dxoverdy/Gliderol2MQTT/README.md

# Gliderol2MQTT
## A smart home interface for Gliderol Electric Garage Doors driven by Glidermatic controllers.
Gliderol2MQTT (or G2M for short) is a smart home remote control and monitoring interface for Gliderol Electric Garage Doors which are driven by Glidermatic controllers.

Let's be honest.  Gliderol garage doors are pretty awesome out of the box, but what if we could make them a bit smarter?  Say, hook them into your Apple Home, Google Assistant, Amazon Alexa or Home Assistant?  Well, now you can.  And you can do it without a soldering iron.  Communication with Gliderol2MQTT is via MQTT and can be driven by home integration solutions such as [Home Assistant](https://www.home-assistant.io/), [Node-Red](https://nodered.org/) and anything else which is MQTT compatible.  It has in-built compatibility with [Homebridge](https://homebridge.io/) and the [Homebridge MQTT-Thing](https://github.com/arachnetech/homebridge-mqttthing) plugin so you can control and monitor your garage door natively from your iPhone/Apple Watch/HomePod with your voice or via the app.  It's as simple as saying "Hey Siri, close the garage door."

Further, as the project is low power and makes use of the 12V/GND/UP/DOWN/STOP screw terminals on the PCB of the Glidermatic controller, it can be powered by the Glidermatic controller itself and so it doesn't need its own power supply.  It supports an optional OLED display for your project box and an optional Micro-SD card reader for changing settings without needing to re-flash the ESP32 each time.  The slightly simpler implementation only requires a roller shutter door sensor on the floor to work, reporting Open / Closed / Opening (Fob/Button/MQTT) / Closing (MQTT).  For best results however, an optional spring actuator limit switch at the top is supported to report the full Open / Stopped / Closed / Opening (Fob/Button/MQTT) / Closing (Fob/Button/MQTT) range of states.

It's designed to run on an ESP32 microcontroller with a small amount of supporting components.  Estimated cost to build is around £40 for the simpler implementation and £65 for the full on implementation... But the kudos is priceless :D.

### Supported devices are:
```
GLIDERMATIC GRD,
GLIDERMATIC GTS / GTS+,
*Others models which expose 12V, GND, UP, STOP and DOWN terminals on the PCB will work too.  Be sure to let me know if yours needs adding!
**There are models which just have a 12V, GND, ST (Start).  Whilst I don't have this model, in theory, Gliderol2MQTT will work just fine, leveraging just one relay for START.  I would love to hear from and work with you if you have a model like this so that the project can be refined for you and all.
```

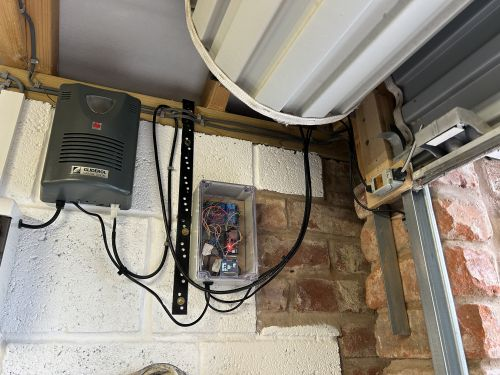
[picture p1: Pics/Assembly/Small/Finished2.JPG]
Gliderol2MQTT


*Watch the video of my implementation here:*

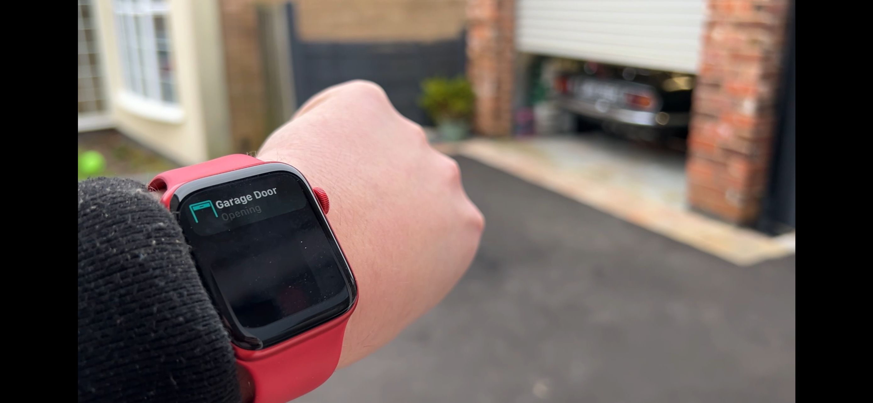
[picture p2: Pics/VidImage.jpg]
Watch the video of my implementation here


We will run through the communications first, we will then look at building and implementation before finally plumbing it into Homebridge or Home Assistant and demonstrate how it all comes together.  I have been running my Gliderol2MQTT for over a year.  I debated whether to release it to the public because it is such a great device it could have been a small side income stream, however, I ultimately decided to release the design and code to the public.  This is not a two minute project.  It is a weekend fun project which involves everything from a bit of DIY, some easy electronics and a teeny bit of ESP32 flashing with PlatformIO in Visual Studio Code.  Have a marathon approach to this project in your head, a sprint will only frustrate you.  I will endeavour to help if you get stuck.  Try email or [Facebook](https://www.facebook.com/mydan100/).

Enjoy.

(c) Daniel Young 2022/23/24 [daniel@mydan.com](daniel@mydan.com)

# MQTT Communication
## Connection Established / Dropped
Gliderol2MQTT needs WiFi access and a connection to an MQTT broker to work.  If MQTT communication is lost for around 20 seconds (1.5 x the 15 second keep-alive) due to patchy WiFi or network outage, Gliderol2MQTT will show as offline.  But rest assured, Gliderol2MQTT will always endeavour to reconnect to both WiFi and MQTT as soon as possible.  Use the following MQTT topic for Birth and Last Will and Testament, which you can use to indicate to HomeKit and Home Assistant that the device is online or offline:
```
Gliderol2MQTT/connection_status
```

### Birth
When connection to the MQTT broker is established, it will post a retained MQTT message to Gliderol2MQTT/connection_status with the following payload:
```
true
```
Where true means Gliderol2MQTT is online.  Gliderol2MQTT is assumed as online from then on - until communication is lost.

### Last Will and Testament
As stated, when MQTT communication is lost for around 20 seconds, your MQTT broker will send out the Last Will and Testament for Gliderol2MQTT.  It is a retained MQTT message to Gliderol2MQTT/connection_status with the following payload:
```
false
```
Where false means Gliderol2MQTT is offline.

### Boot Report
Once per boot, after first connecting to the broker, Gliderol2MQTT publishes a retained JSON message to:
```
Gliderol2MQTT/device/boot
```
For example:
```
{"time": "2026-11-07T08:15:02Z", "reset_reason": "software", "boot_count": 42, "online_after_ms": 12873,
 "version": "v2.0", "firmware_md5": "3f2a...", "ip": "192.168.1.50", "mac": "0x..."}
```
- **time** - UTC, from NTP.  `null` if the time couldn't be fetched.
- **reset_reason** - `power_on`, `external` (reset button), `software` (includes the reboot after an OTA update), `crash`, `watchdog`, `brownout` (supply voltage dipped) or `unknown`.
- **boot_count** - boots since first flashed; survives reboots and reflashing.
- **online_after_ms** - time from power-on to this message.  It includes the "Determine status" wait, so expect a little over your longest door time.
- **firmware_md5** - fingerprint of the running firmware; it changes with every build, which confirms an OTA update really landed.
- **rssi** - WiFi signal strength in dBm at boot.  Roughly: above -60 excellent, -60 to -70 good, -70 to -80 weak, below -80 unreliable.

### Device Status
Every minute (and on connecting), Gliderol2MQTT publishes a retained health report to:
```
Gliderol2MQTT/device/status
```
For example:
```
{"uptime_s":86400,"rssi":-63,"free_heap":201468,"min_free_heap":187952}
```
- **uptime_s** - seconds since boot.
- **rssi** - current WiFi signal strength in dBm (see above).
- **free_heap** / **min_free_heap** - free memory now, and the lowest it has been since boot.  A steady downward trend over days would point to a memory leak.

If the firmware ever hangs, a watchdog reboots it after 30 seconds, and the boot report then shows `"reset_reason": "watchdog"`.

## Current State
The MQTT topic to subscribe to is:
```
Gliderol2MQTT/get/current/door/state
```
### get/current/door/state
To keep your home automation tools informed as to your garage door's current state, Gliderol2MQTT publishes this topic every minute and whenever it (re)connects to the broker.  This topic is also published on demand when there is either a change of floor sensor or top sensor state, or when you tell Gliderol2MQTT to do something.  For example, if you instruct Gliderol2MQTT to open the door via an MQTT message, the topic will be published immediately.  If there is a change in door state by way of using the keyfob or push button on the Glidermatic, it will likewise publish the topic immediately.   To take two real life examples a bit further, if you send Gliderol2MQTT a message to shut the door, this will return 'c' (Closing) for a time period* and then, if the door has fully shut, return 'C' (Closed) from then on.  Similarly, if you use the fob to open the door from a fully closed position, this will return 'o' (Opening) for a time period* and then, if the door has fully opened, return 'O' (Open) from then on.  With the top sensor fitted, it reports the final state the moment the sensor at the destination confirms the door has arrived, without waiting out the time period.  If the time period* passes with the door still part-way, it allows a further five seconds' grace (`MOVEMENT_GRACE_MS`) in case the door is just running slow, and only then reports 'S' (Stopped).

```
o - The door is currently Opening.
O - The door is currently Open.
c - The door is currently Closing.
C - The door is currently Closed.
S - The door is currently Stopped.
```

*Time Periods are customisable numbers of seconds it takes for your garage door to both open from a fully closed position or close from a fully open position - as these are all dependent on the model and the height of the door.*

*Without the top sensor as part of your implementation, only 'o' and 'O' can be reported on change of floor sensor state or if you instruct Gliderol2MQTT to open the door by way of an MQTT message.  Further, 'c' and 'C' can only be reported when the door is fully shut or if you instruct Gliderol2MQTT to close the door by way of an MQTT message.  This is because a change in top sensor state is required to determine if you close the door with the keyfob or push button on the Glidermatic.  'S' cannot be reported without the top sensor as both sensor states need to be known to determine if the door is stopped somewhere between.*

## Target State
The MQTT topic to subscribe to is:
```
Gliderol2MQTT/get/target/door/state
```
### get/target/door/state
This informs your home automation tool as to what the target door state is and is only sent out on demand.  Take two examples, if you send Gliderol2MQTT a message to shut the door, this will return 'C' (Closed) - Our target is an eventual closed position.  And if you press the keyfob to open the door from a fully closed position, this will return 'O' (Open) - Our target is an eventual open position.  

*Without the top sensor as part of your implementation, only 'O' can be reported on change of floor sensor state or if you instruct Gliderol2MQTT to open the door by way of an MQTT message.  Further, 'C' can only be reported when the door is fully shut or if you instruct Gliderol2MQTT to close the door by way of an MQTT message.  This is because a change in top sensor state is required to determine if you close the door with the keyfob or push button on the Glidermatic.*
```
O - The door is working towards its Open position.
C - The door is working towards its Closed position.
```

## Requesting States
You can ask Gliderol2MQTT about the state of the door as it is right now.  The MQTT topics to publish empty payloads to are:
```
Gliderol2MQTT/request/is/open
Gliderol2MQTT/request/is/closed
Gliderol2MQTT/request/is/stopped
```

### request/is/open
Following an empty payload published to the topic 'Gliderol2MQTT/request/is/open', you will receive a response on Gliderol2MQTT/response/is/open.  The response payload is JSON akin to the following:
```
{"open":true}
```
The value is true (Door open) or false (Door not open.)

### request/is/closed
Following an empty payload published to the topic 'Gliderol2MQTT/request/is/closed', you will receive a response on Gliderol2MQTT/response/is/closed.  The response payload is JSON akin to the following:
```
{"closed":true}
```
The value is true (Door closed) or false (Door not closed.)

### request/is/stopped
Following an empty payload published to the topic 'Gliderol2MQTT/request/is/stopped', you will receive a response on Gliderol2MQTT/response/is/stopped.  The response payload is JSON akin to the following:
```
{"partiallyopen":true}
```
The value is true (Door partially open) or false (Door fully closed or open.)

*When you leverage a top sensor as part of your implementation.*

## Requesting Actions
You can ask Gliderol2MQTT to open, close or stop the door from home automation tools such as Home Assistant or Node Red.  The MQTT topics to publish empty payloads to are:
```
Gliderol2MQTT/request/perform/close
Gliderol2MQTT/request/perform/open
Gliderol2MQTT/request/perform/stop
```

You can also ask Gliderol2MQTT to reboot itself:
```
Gliderol2MQTT/request/perform/reboot
```

If you are integrating with HomeKit using Homebridge and MQTT-Thing, Gliderol2MQTT has you covered.  You use this topic instead:
```
Gliderol2MQTT/set/target/door/state
```

### set/target/door/state
This topic instructs Gliderol2MQTT to open (O) or close (C) the door.  Simply publish a message to this topic with a single character payload, the letter C or letter O.  This works out of the box with MQTT-Thing but can also be used in any other home automation tools too.
```
O - The door is working towards its Open position.
C - The door is working towards its Closed position.
```
Once you have published to this topic, you will receive the same payload back to 'Gliderol2MQTT/get/target/door/state' as confirmation that the target was set.

*This indicates the action was triggered, but does not guarantee anything.  Your home automation will use the current state to report the outcome over time.*

### request/perform/close
Following an empty payload published to the topic 'Gliderol2MQTT/request/perform/close', you will receive a response on Gliderol2MQTT/response/perform/close.  The response payload is JSON akin to the following:
```
{"statusValue":"setCloseSuccess","done":true}
```
*This indicates the action was triggered, but does not guarantee anything.  Your home automation will use the current state to report the outcome over time.*

### request/perform/open
Following an empty payload published to the topic 'Gliderol2MQTT/request/perform/open', you will receive a response on Gliderol2MQTT/response/perform/open.  The response payload is JSON akin to the following:
```
{"statusValue":"setOpenSuccess","done":true}
```
*This indicates the action was triggered, but does not guarantee anything.  Your home automation will use the current state to report the outcome over time.*

### request/perform/stop
Following an empty payload published to the topic 'Gliderol2MQTT/request/perform/stop', you will receive a response on Gliderol2MQTT/response/perform/stop.  The response payload is JSON akin to the following:
```
{"statusValue":"setStopSuccess","done":true}
```
*This indicates the action was triggered, but does not guarantee anything.  Your home automation will use the target and current states to report the outcome.*

### request/perform/reboot
Following an empty payload published to the topic 'Gliderol2MQTT/request/perform/reboot', you will receive a response on Gliderol2MQTT/response/perform/reboot, after which the device releases all relays, publishes `false` to connection_status and restarts.  The response payload is JSON akin to the following:
```
{"statusValue":"setRebootSuccess","done":true}
```
Once back online, Gliderol2MQTT/device/boot will show `"reset_reason": "software"`.

### Retained command messages
Command topics (perform open/close/stop/reboot and set/target/door/state) must not be published with the retain flag.  As a safeguard, Gliderol2MQTT deletes any retained message on its command topics each time it connects, and ignores commands arriving in the first 1.5 seconds after subscribing - otherwise a stray retained "open" would open the door, or a retained "reboot" would cause a reboot loop, every time the device reconnected.

## Other MQTT Topics
There are other topics which were implemented to assist in development.  They are listed below but without too much by way of detail.  They set, clear and return the individual ESP32 pin values for the relays driving the garage door and the sensor values.  The value topics reply with `{"value":"high"}` or `{"value":"low"}`, and set/clear reply with `{"done":true}`.  You shouldn't need them, but it gives those of you who investigate the source code in depth some context.
```
Gliderol2MQTT/request/value/pin/close, Response via Gliderol2MQTT/response/value/pin/close
Gliderol2MQTT/request/value/pin/stop, Response via Gliderol2MQTT/response/value/pin/stop
Gliderol2MQTT/request/value/pin/open, Response via Gliderol2MQTT/response/value/pin/open
Gliderol2MQTT/request/value/pin/top_sensor, Response via Gliderol2MQTT/response/value/pin/top_sensor
Gliderol2MQTT/request/value/pin/bottom_sensor, Response via Gliderol2MQTT/response/value/pin/bottom_sensor
Gliderol2MQTT/request/value/pin/wake_button, Response via Gliderol2MQTT/response/value/pin/wake_button
```

*The set and clear topics below directly energise/release the relays, so they are compiled out by default.  Uncomment `#define ENABLE_DEV_TOPICS` in Definitions.h to enable them.*
```
Gliderol2MQTT/request/set/value/pin/close, Response via Gliderol2MQTT/response/set/value/pin/close
Gliderol2MQTT/request/set/value/pin/stop, Response via Gliderol2MQTT/response/set/value/pin/stop
Gliderol2MQTT/request/set/value/pin/open, Response via Gliderol2MQTT/response/set/value/pin/open

Gliderol2MQTT/request/clear/value/pin/close, Response via Gliderol2MQTT/response/clear/value/pin/close
Gliderol2MQTT/request/clear/value/pin/stop, Response via Gliderol2MQTT/response/clear/value/pin/stop
Gliderol2MQTT/request/clear/value/pin/open, Response via Gliderol2MQTT/response/clear/value/pin/open
```

# How To Build
## Parts List
1. An ESP32 microcontroller

2. A 3-channel 3.3V DC relay board

3. A prototyping board - 120mm x 80mm

4. A 12V to 5V step down buck converter*

5. A 4-pin IIC 128x64 OLED Screen (optional)

6. A Micro-SD Card Reader (optional)

7. A roller shutter door sensor

8. A spring actuator limit switch (optional)

9. Some 5 Core 30 AWG Cable**

10. Some 2 Core 30 AWG Cable***

11. A project box to put it all in

12. Miscellaneous 2.54mm pitch male and female headers, and mix of varying length Female-Female (F-F) jumper wires

*I have designed this project with zero soldering in mind, but ultimately my personal implementation does use soldering as I have a small soldering kit and I'm pretty competent at it and it made for a slightly tidier job.  You will be able to implement this entirely solderless using breadboards.  The only component where I couldn't find a pre-soldered equivalent was the 12V to 5V converter.  I suspect they will be available if you search a little harder than I did.  I like the 12V to 5V converter as it means the whole thing can be powered from the Glidermatic itself but it isn't essential as you could use your own Micro-USB power supply for the ESP32.

** You will need enough 5 core cable to reach from your Glidermatic to wherever you fix your Gliderol2MQTT.  I listed the item below but you can do as I did, position it near the glidermatic and use any spare 1m network cable you have lying around if you want to save yourself a bit of money.  Black is likely to be a better colour for the project.

*** You will need enough 2 core cable to reach from your Gliderol2MQTT to the bottom sensor, and optionally, a second length from your Gliderol2MQTT to the top sensor, if you choose to implement the top sensor.  Black is likely to be a better colour for the project.

### ESP32 + optional case : ESP32-WROOM-32E : Development Board Dual Core : LATEST!
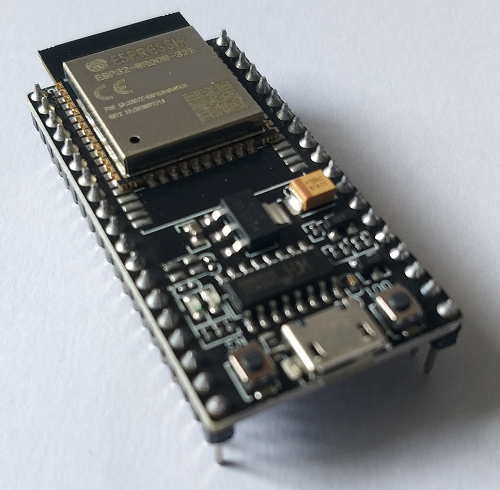
[picture p3: Pics/ESP32.png]
ESP32-WROOM-32E


Forgoe the box.  I guess any ESP32 variant will do, but I use the 38 pin version with 3V3 and GND at the top left and right respectively.  I bought [for £6.95 including P&P](https://www.ebay.co.uk/itm/195866751998)

### DC 3.3V 5V 3-Channel Relay Module With Optocoupler Isolation Compatible Signal
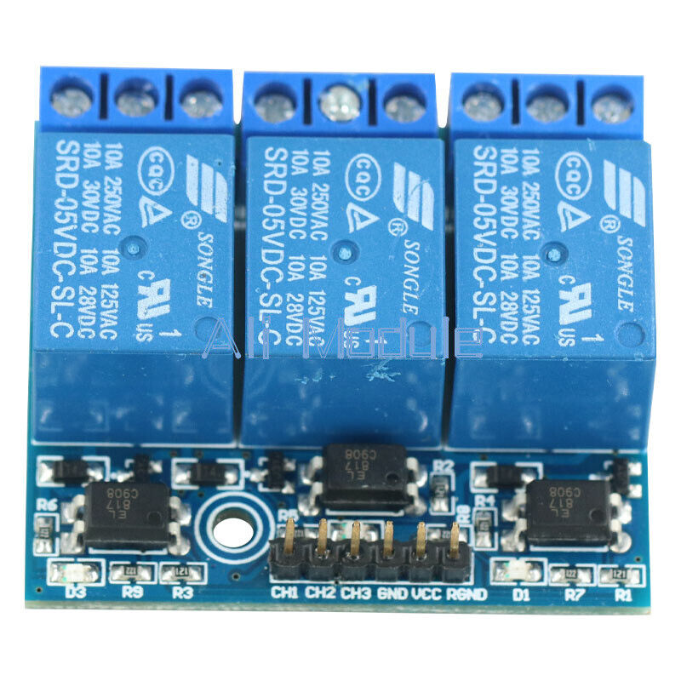
[picture p4: Pics/RelayBoard.JPG]
3 Channel Relay Board


I bought [for £4.69 including P&P](https://www.ebay.co.uk/itm/254991837221)

*Note that this relay board is powered by 5V to activate the relays, however is driven by 3.3V signals.  You may find a relay board which can be powered by 3.3V too and you will need to adjust your build below such that you have a 3.3V rail to share with any other 3.3V devices, such as the display.*

### Prototype Board - Double Sided - 80x120mm - 8x12cm Green / Silver - UK Free P&P
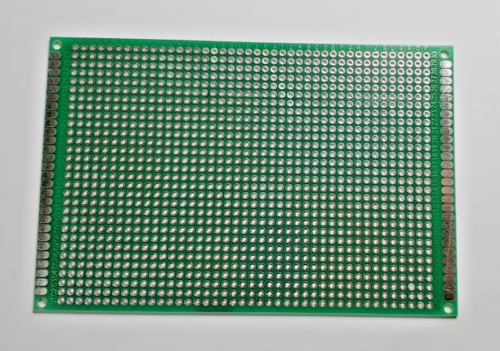
[picture p5: Pics/PrototypingBoard.PNG]
Prototyping Board


I bought [this for £2.99 including P&P](https://www.ebay.co.uk/itm/266162433248)

### Mini560 5V-20V To 3.3V/5V/9V/12V 5A Step Down Buck Converter Power Supply -UK
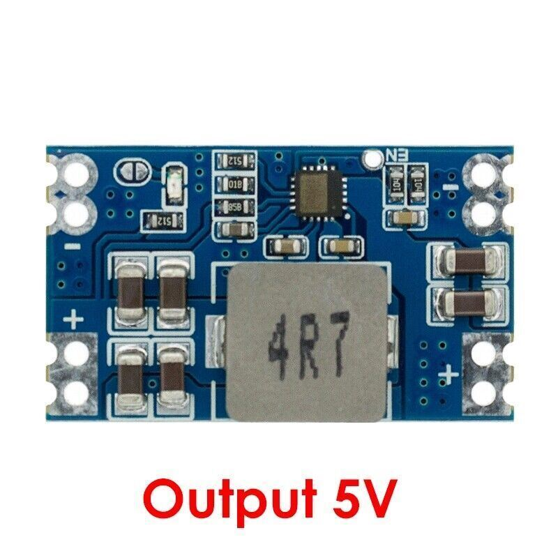
[picture p6: Pics/12V5VConverter.jpg]
12V to 5V Step Down Buck Converter


You want the 5V output variant.  I bought [this for £3.90 including P&P](https://www.ebay.co.uk/itm/194950043266?var=494844251955)

### 1.3" 128x64 IIC I2C OLED LCD Display Module for Arduino White SOLDERED
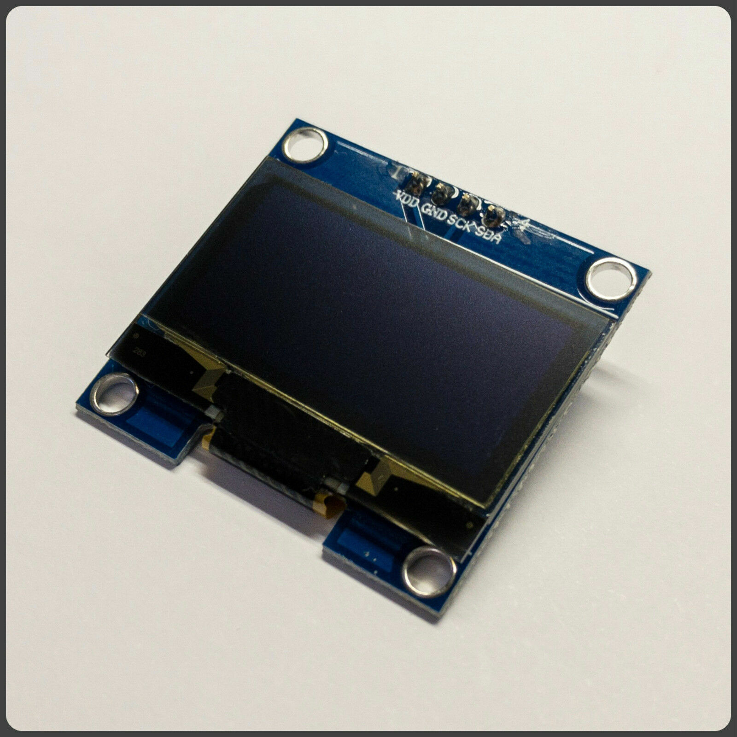
[picture p7: Pics/Screen.jpg]
OLED Screen


You want the IIC (aka I2C) 4-pin (VCC,GND,SCK,SDA) variant with the SH1106 driver.  I bought [this for £5.99 including P&P](https://www.ebay.co.uk/itm/234964172688)

### 2pcs Micro SD Card Adapter Module 6 Pin SPI for Microcontroller ESP32 ESP8266
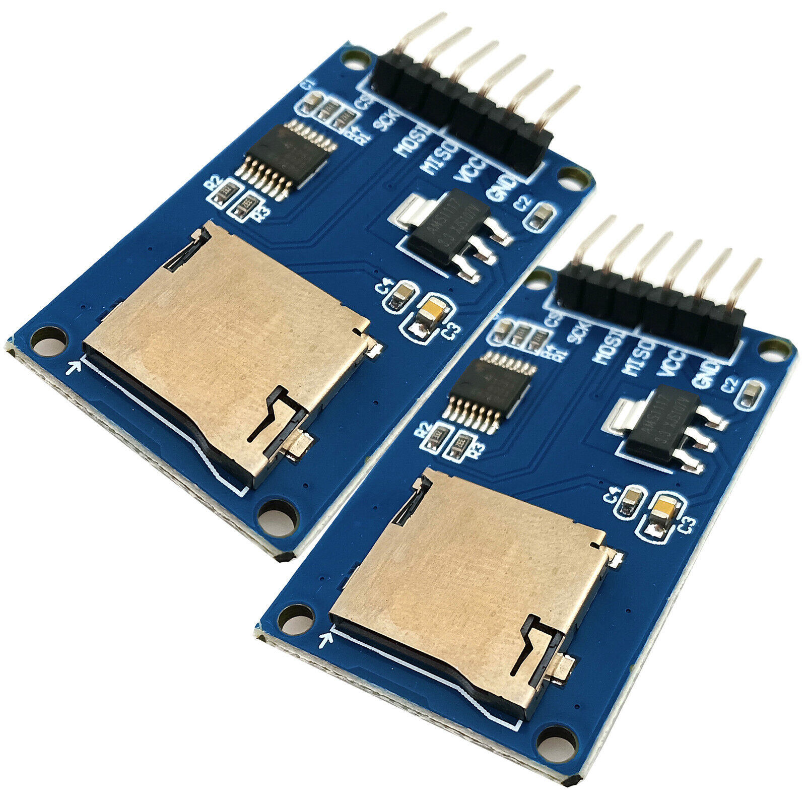
[picture p8: Pics/MicroSDReader.jpg]
Micro-SD Card Reader


I bought [this 2-pack for £3.52 including P&P](https://www.ebay.co.uk/itm/394519186781)

*Note that this Micro-SD card reader is powered by 5V, however is driven by 3.3V signals.  You may find a card reader which can be powered by 3.3V too (such as the Wemos Lolin SD-Card Reader) and you will need to adjust your build below such that you have a 3.3V rail to share with any other 3.3V devices, such as the display.*

### Knight F10A Roller Shutter Switch Door Contact Alarm Switch Sensor Normally Open
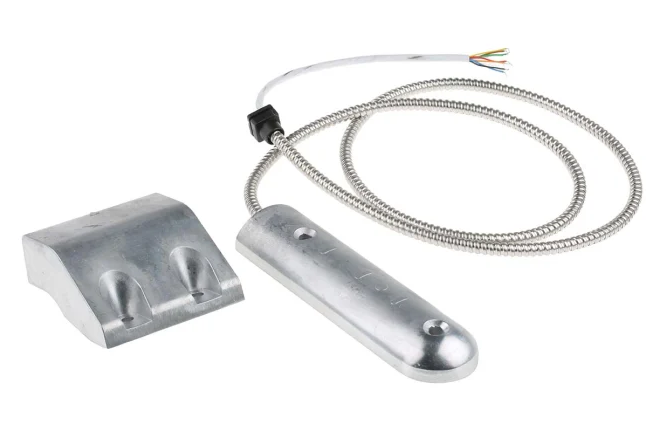
[picture p9: Pics/RollerShutter.PNG]
Roller Shutter Switch


I bought [this for £12.95 including P&P](https://www.ebay.co.uk/itm/224354305842)

### IP65 Spring Actuator Limit Switch NO/NC 250V 5A
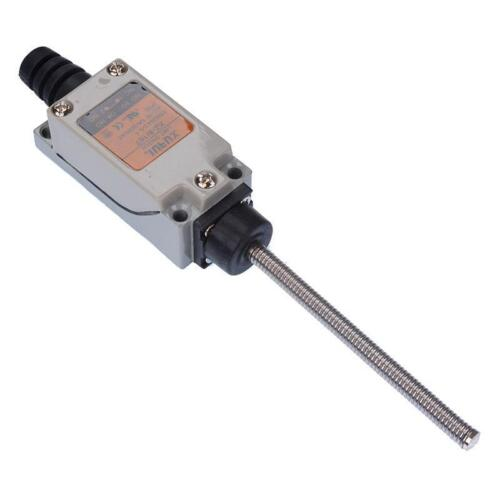
[picture p10: Pics/SpringActuatorLimitSwitch.jpg]
Spring Actuator Limit Switch


I bought [this for £9.99 including P&P](https://www.ebay.co.uk/itm/255671000806)

### 16~30 AWG PVC Multi Core Power Wire 2/3/4/5/6/7/8/9/10 Core Signal Control Cable
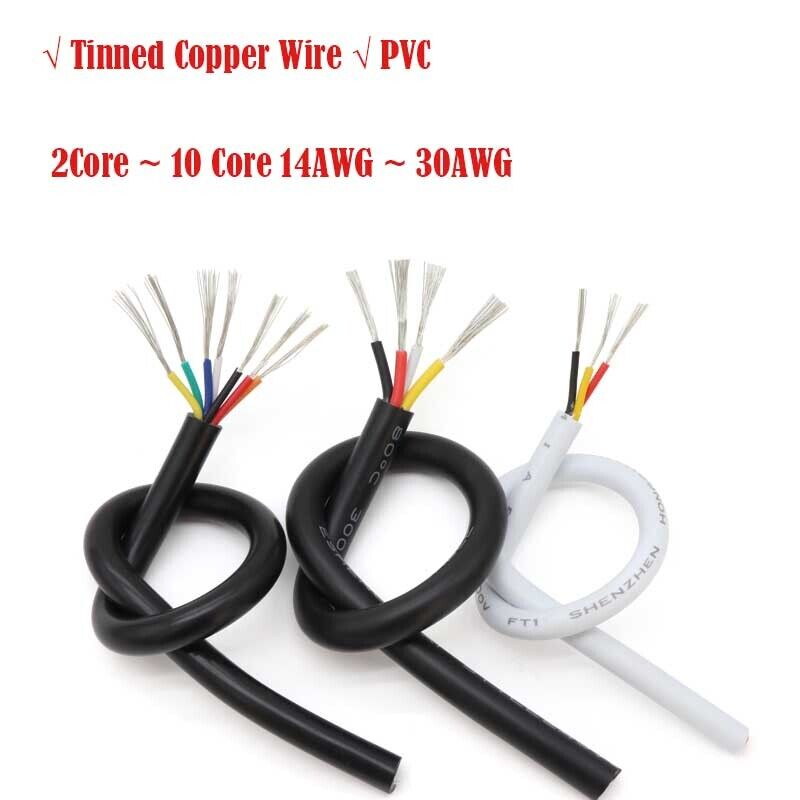
[picture p11: Pics/Wire.PNG]
5 Core Wire


I used a spare network cable, but you can buy lengths [from £3.49 including P&P](https://www.ebay.co.uk/itm/404344258322)

### 16~30 AWG PVC Multi Core Power Wire 2/3/4/5/6/7/8/9/10 Core Signal Control Cable
2 Core Wire

I used a spare length of telecoms cable, but you can buy 10m lengths [from £5.28 including P&P](https://www.ebay.co.uk/itm/404344258322)

### IP65 Waterproof Junction Box, Electronics Project Box, Plastic Clear Cover Project Junction Box Enclosure Case, Electrical Box Outdoor Cable Connector Boxes
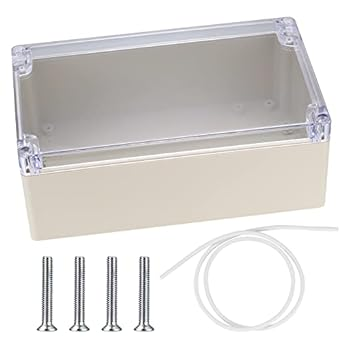
[picture p12: Pics/ProjectBox.jpg]
Project Box


You want the 200mm x 120mm x 75mm variant.  I bought [this for £8.59 including P&P](https://www.amazon.co.uk/gp/product/B0B2MJH7Q5/ref=ppx_yo_dt_b_search_asin_title?ie=UTF8&th=1)

### 40pin 2.54mm Single Row Male Pin Header for Arduino uno MINI R3 ETC snap to size
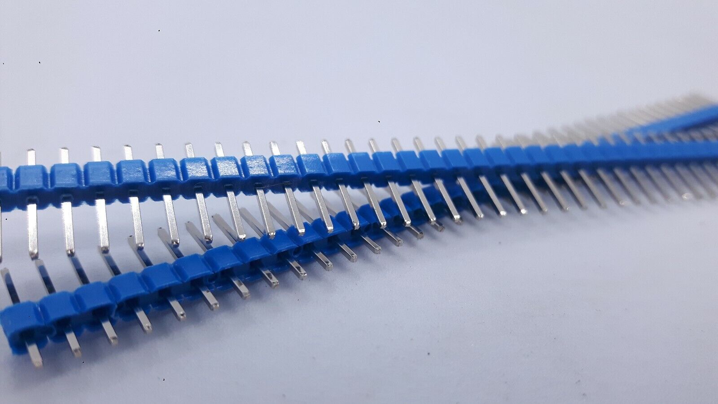
[picture p13: Pics/MaleHeader.jpg]
Male Headers


You can buy male headers [here](https://www.ebay.co.uk/itm/123991187180)

### Single Row Round Hole Female Header Pin Header 2.54MM 1*4/40P 2*40 Gold Plated
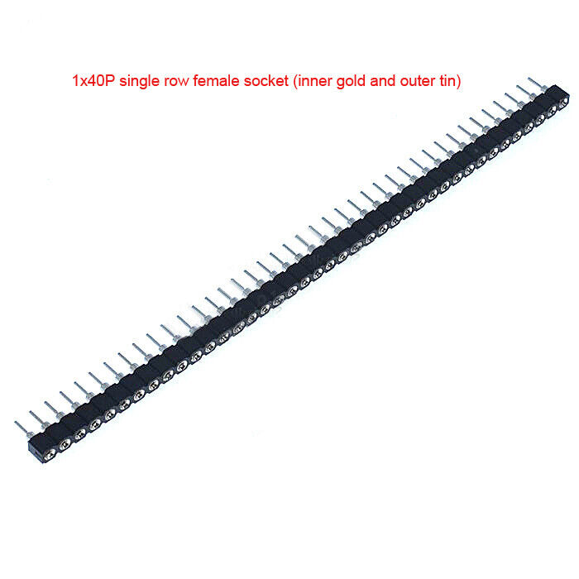
[picture p14: Pics/FemaleHeader.jpg]
Female Headers


You can buy female headers [here](https://www.ebay.co.uk/itm/354733633355)

### 40 PIN DUPONT WIRE BREADBOARD JUMPER WIRES RIBBON CABLES M-F/M-M/F-F 10/20/30CM
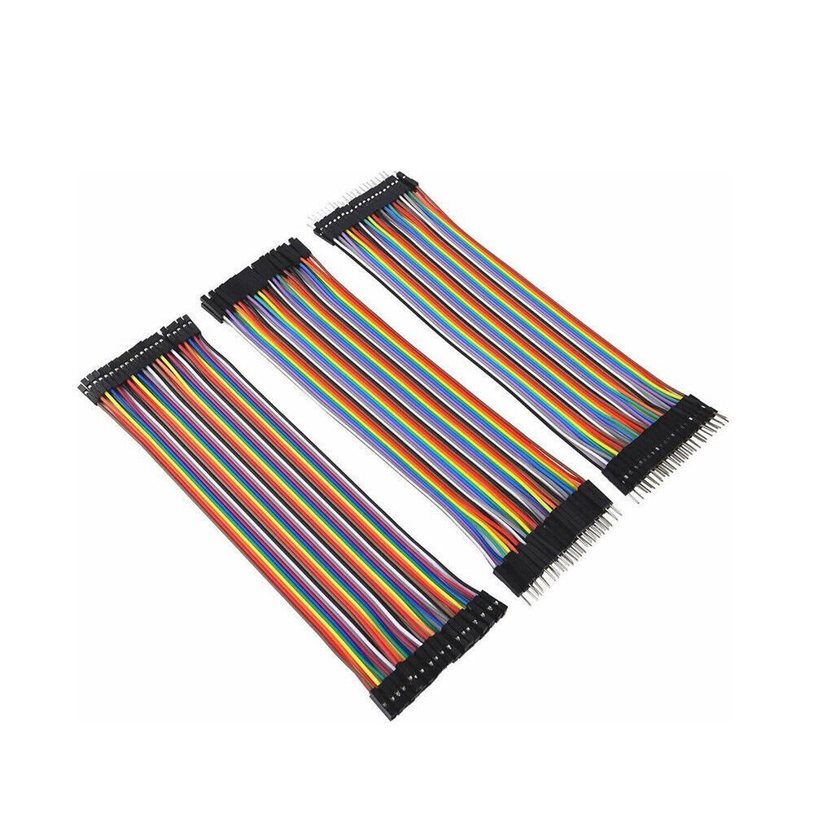
[picture p15: Pics/JumperWires.jpg]
Jumper Wires


You can buy a selection of jumper wires (though I only use Female-Female between 10cm and 15cm) [here](https://www.ebay.co.uk/itm/223760125560)

What I would consider a 'Gold Standard' approach of both sensors, Micro-SD card reader and OLED screen, plus a nominal £5 for bits and bobs will set you back around £65, including 10m of 2 core cable and 1m of 5 core cable.  A slimmed back implementation with no Micro-SD card reader, no OLED screen, just the floor sensor and cables you have lying around will set you back around £40.

## Schematic and ESP32 Pinout
The full schematic is below and you can click on it to open a larger copy.  This is what we will be building today.

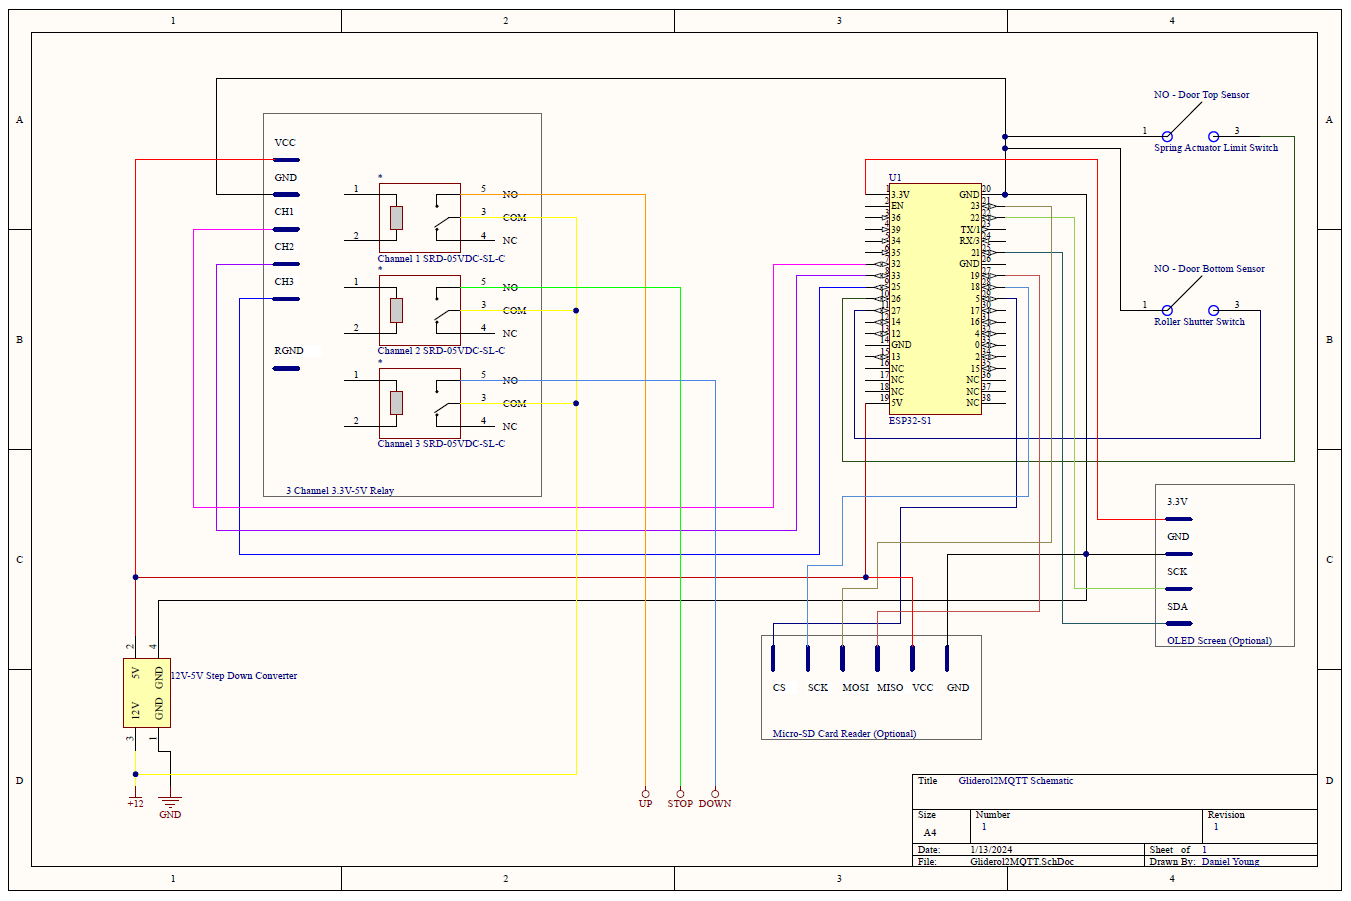
[picture p16: Pics/Schematic.PNG]
Schematic


You can download a PDF of the schematic [here](Pics/Schematic.pdf).

The ESP32 pinout is here for your reference and you can click on it to open a larger copy.  Credit to [uPesy](https://www.upesy.com/blogs/tutorials/esp32-pinout-reference-gpio-pins-ultimate-guide) for creating this image as part of their awesome guide.

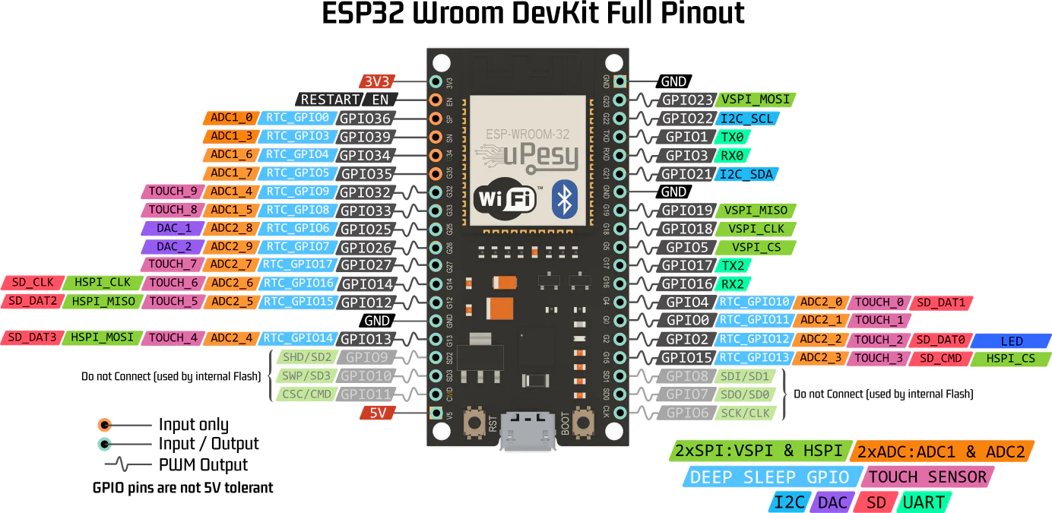
[picture p17: Pics/doc-esp32-pinout-reference-wroom-devkit.webp]
ESP32


## Construction
### Device Placement
Click any image for a full size copy.  I will build mine using some soldered components on a prototyping board.  If you are building on breadboards simply plug and play.  My prototyping board will be positioned in portrait.  I would never recommend soldering components directly to the board.

Start by soldering 2 x 19 pin female headers and 2 x 19 pin male headers to the far most bottom right of the prototyping board vertically.  I had some plastic female headers handy so used those.  On the underside, solder equivalent pins adjacent to each other.  This will give us a male pin for every pin of the ESP32 and give us a removable socket for swapping out the ESP32, should we need to.

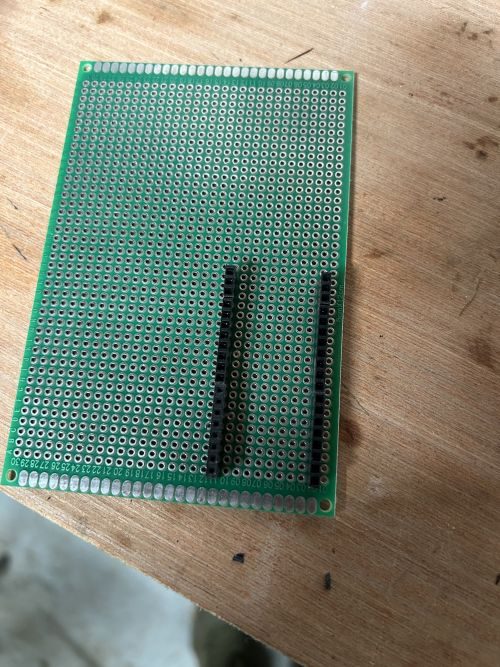
[picture p18: Pics/Assembly/Small/Assembly1.JPG]


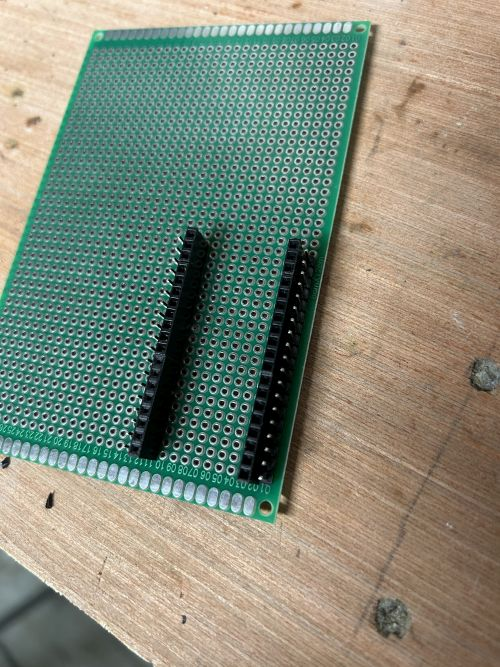
[picture p19: Pics/Assembly/Small/Assembly2.JPG]


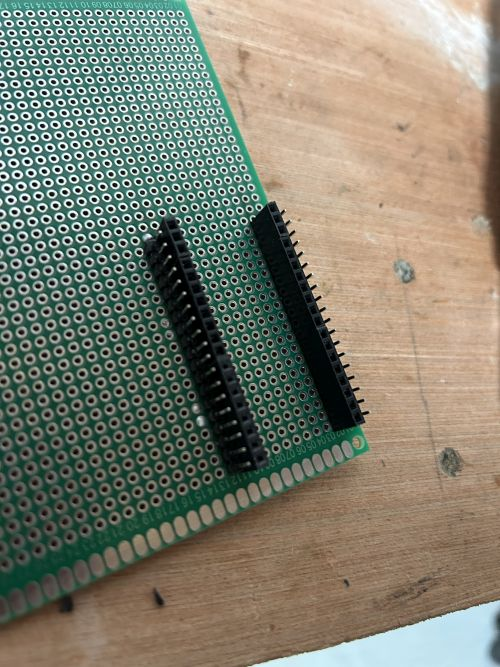
[picture p20: Pics/Assembly/Small/Assembly3.JPG]


I'll be honest, I didn't bother soldering all the equivalent pins when it became apparent it was going to be more effort than it was worth.  I soldered all the corners and then ensured that the pins in use in the project (5V/GND/3v3/GPIOs 23,22,21,19,18,5,32,33,25,26,27) had equivalents.  Ensure you don't have any shorts.  It ended up looking like this:

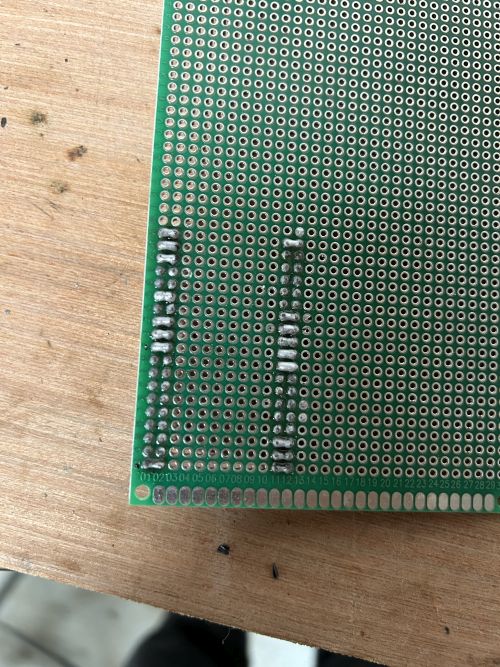
[picture p21: Pics/Assembly/Small/Assembly4.JPG]


Next, at the bottom left of the board, we will make an interface port.  Solder 2 x 9 pin male headers vertically.  On the underside, solder equivalent pins adjacent to each other.  This will give us a male pin for each of the 12V, GND, UP, STOP, DOWN from the Glidermatic, as well as 2 pins each for the top and bottom door sensors.  Solder one final 1 x 1 pin male at the top and likewise solder underneath to the existing 12V pair.  In effect you'll end up with 2 columns of 9, and 1 column of 1.  Soldering the adjacent pins will give us a male pin for all the inputs and outputs from Gliderol2MQTT, bar 12V which will get two outputs.  Take out a sharp permenant marker and write the following beside each pin, from top to bottom, 12, G, U, S, D, T1, T2, B1, B2.

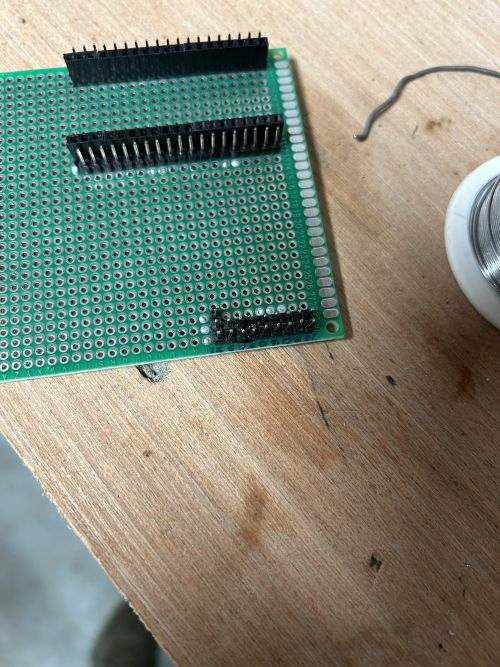
[picture p22: Pics/Assembly/Small/Assembly6.JPG]


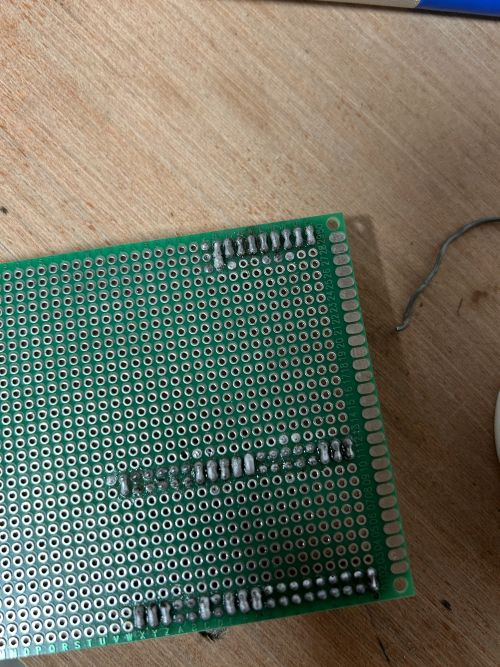
[picture p23: Pics/Assembly/Small/Assembly7.JPG]


Next, solder some male pins to the 12V-5V converter.  The converters I got don't conform to 2.54mm as per prototyping, but are close enough to get away with slight bends.

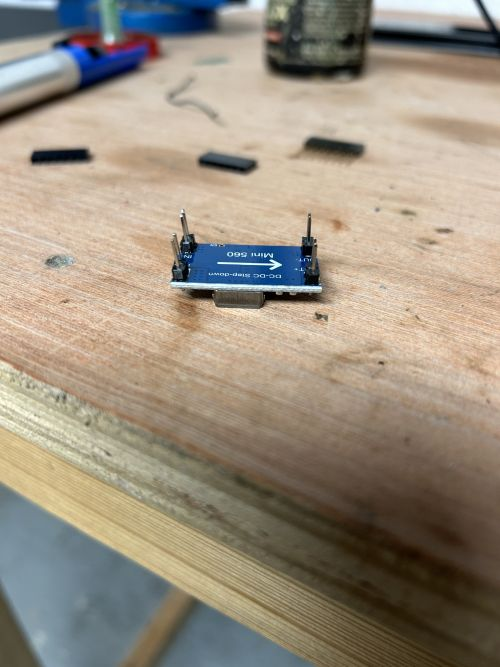
[picture p24: Pics/Assembly/Small/Assembly5.JPG]


Look at the relay board and identify common and normally open.  I wrote O and | and C for Open, Common and Closed respectively.  This is because when the board is fixed to the prototyping board you won't see the circuit diagram anymore.

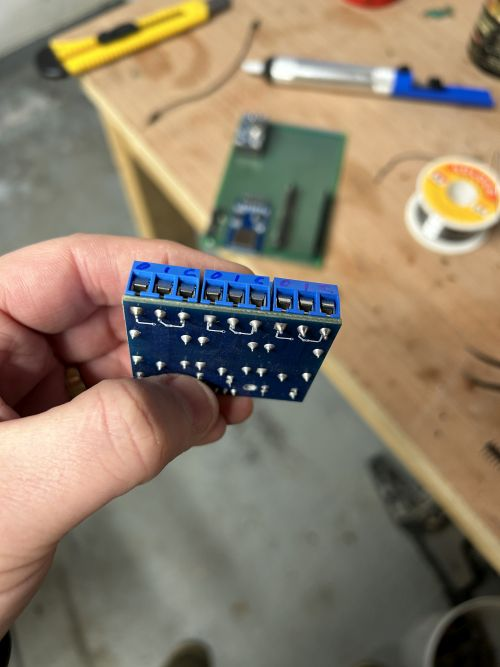
[picture p25: Pics/Assembly/Small/Assembly8.JPG]


Take the relay board and place it at the far top right of the prototyping board vertically with the relay outputs pointing towards the inside of the board.  You have a choice, you can use a felt-tip to mark holes and, using an appropriate drill, drill holes in the prototype board and use small factor bolts and washers to mount the relay board to the prototyping board.  Alternatively, if you feel comfortable using hot melt glue, you can use that.

Take the Micro-SD card reader and place vertically next to the ESP32 such that the card can be ejected from the edge.  Again, you have a choice, you can use a felt-tip to mark holes and, using an appropriate drill, drill holes in the prototype board and use small factor bolts and washers to mount the SD card reader to the prototyping board.  Alternatively, if you feel comfortable using hot melt glue, you can use that.

At this point, your prototyping board should look similar to this:

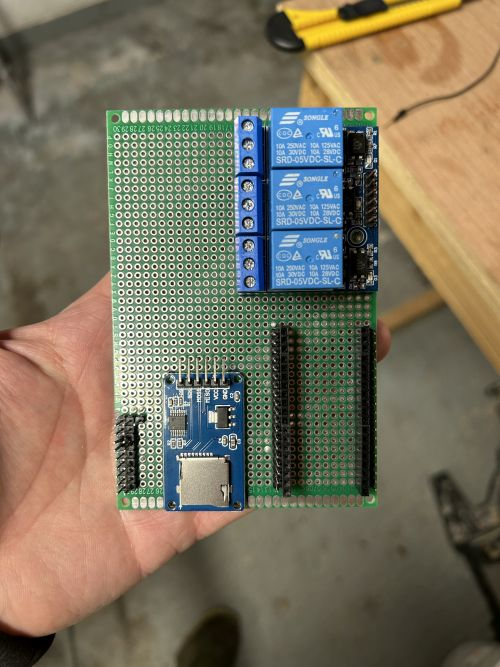
[picture p26: Pics/Assembly/Small/Assembly9.JPG]


Next, slightly in from the top left of the board, solder 2 x 7 pin female headers to the board such that the 12V-5V converter will push in vertically.  You want the 12V side at the top and the 5V side at the bottom.  The middle three pins of the headers are redundant.  Further, solder pairs of adjacent male headers next to the female headers and solder them to the adjacent pins underneath to give us a male pin for inputs and outputs of the converter.  Your prototyping board should be coming along nicely:

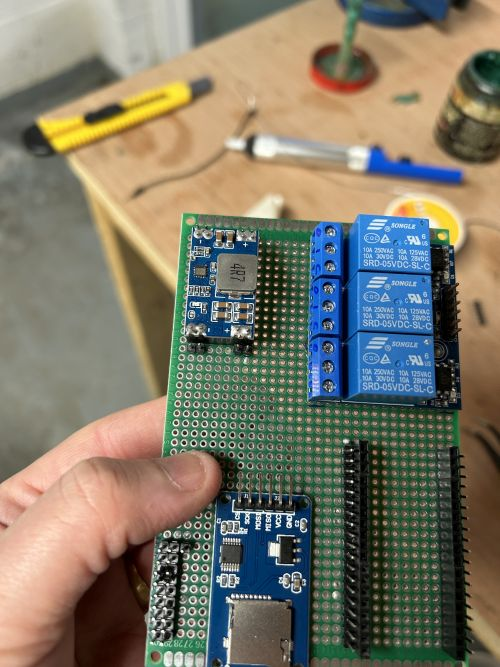
[picture p27: Pics/Assembly/Small/Assembly10.JPG]


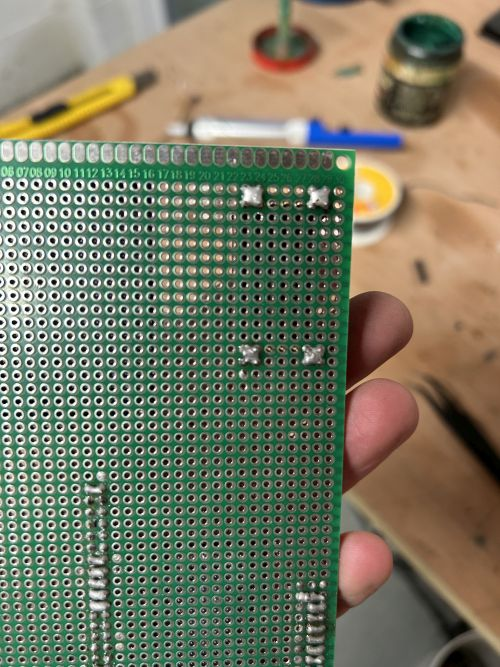
[picture p28: Pics/Assembly/Small/Assembly11.JPG]


Next, we need to make some rails for devices to share.  We need one for 5V, one for GND.

We have six devices which need a GND connection and one device which will supply the GND.  The ESP32, relay board, Micro-SD card reader, OLED display, bottom switch, top switch and the output from the 12V-5V converter.  As such, solder a set of eight male headers (to allow for future project growth) vertically to the left side of the board beneath the converter.  On the underside, ensure all the pins are soldered together.  Using the sharp permenant marker, write GND beside it.

Similarly, we have three devices which need a 5V connection and one device which will supply the 5V.  The relay board, Micro-SD card reader, ESP32 and the supply 5V output from the converter respectively.  As such, solder eight male headers to the right of the GND rail.  Leave some breathing space.  On the underside, ensure all the pins are soldered together.  Using the sharp permenant marker, write 5V beside it.

*It is at this point I'll remind you that if you have sourced a relay board or Micro-SD card reader which require a 3.3V supply, it will be prudent now to take another set of male headers and solder them to the middle of the board somewhere.  On the underside, likewise, ensure all the pins are soldered together.  Using the sharp permenant marker, write 3.3V beside it*

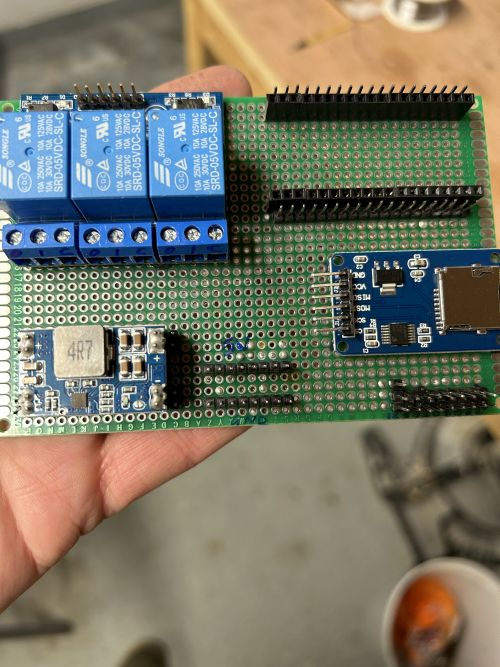
[picture p29: Pics/Assembly/Small/Assembly12.JPG]


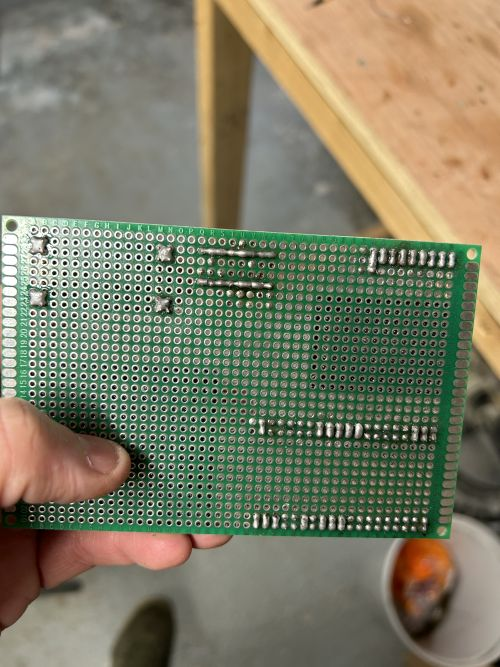
[picture p30: Pics/Assembly/Small/Assembly13.JPG]


This is a quick fun bit, push the ESP32 into its new home so the Micro-USB is at the bottom.  The display will float on wires and, using some double-sided clear tape or hot melt glue, will be fastened to the front of the project box.

### Wiring
Let's now wire up the relays.  I like to use yellow for 12V.  Seeing as I had loads of jumper wires left over of various types, I just snipped and trimmed end(s) off F-F jumper wires as appropriate.

1. Use a F-F jumper wire, cut off, trim back and twist tight one end.  Plug the female end on the middle 12V pin of the interface port to COM (Usually middle pin) on CH3's relay
2. Join CH3 COM (Usually middle pin) to CH2 COM (Usually middle pin)
3. Join CH2 COM (Usually middle pin) to CH1 COM (Usually middle pin)

Alternatively, you can prepare the wire in advance like so by trimming appropriate lengths, twisting together meaning you only need to push one thing into the relays:

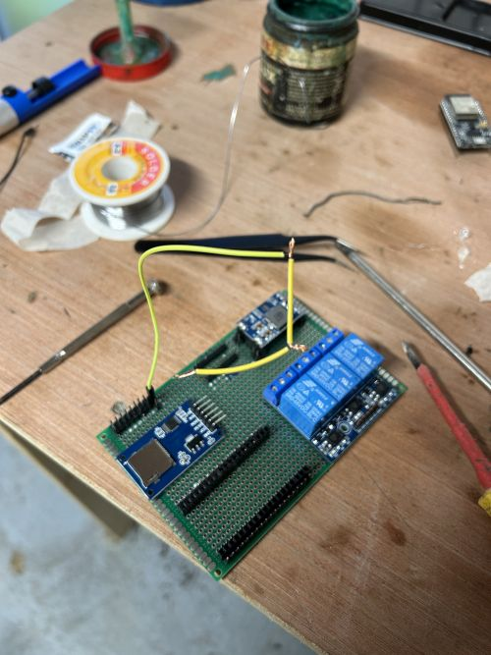
[picture p31: Pics/Assembly/Small/Assembly14.JPG]


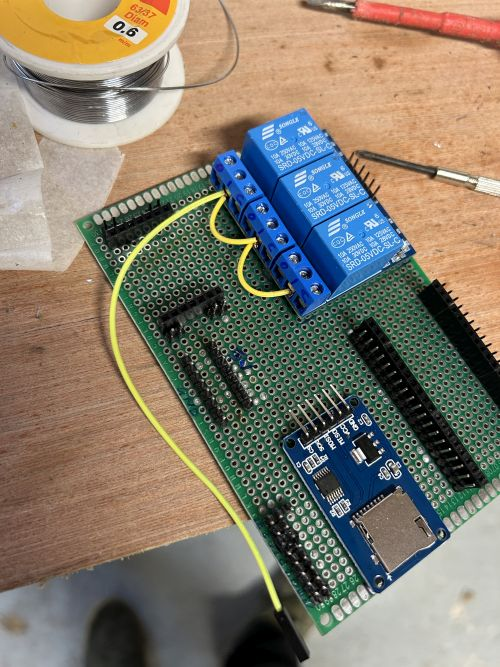
[picture p32: Pics/Assembly/Small/Assembly15.JPG]


For the Normally Open outputs of the relays, follow these steps:

1. Use a F-F jumper wire, cut off, trim back and twist tight one end.  Plug the female end on the right side U of the interface port to Normally Open (NO) (Usually top pin as viewed from above) on CH1's relay
2. Use a F-F jumper wire, cut off, trim back and twist tight one end.  Plug the female end on the right side S of the interface port to Normally Open (NO) (Usually top pin as viewed from above) on CH2's relay
3. Use a F-F jumper wire, cut off, trim back and twist tight one end.  Plug the female end on the right side D of the interface port to Normally Open (NO) (Usually top pin as viewed from above) on CH3's relay

And now all the jumper wires.  This is slightly less fun, but still a satisfying thing to do.
1. Use a F-F jumper wire to connect the right most 12V of the interface port to the 12V input of the converter
2. Use a F-F jumper wire to connect the right most GND to the GND input of the converter
3. Use a F-F jumper wire to connect the 5V output from the converter to the 5V rail
4. Use a F-F jumper wire to connect the GND output from the converter to the GND rail
5. Use a F-F jumper wire to connect the right most B1 of the interface port to the GND rail
6. Use a F-F jumper wire to connect the right most T1 of the interface port to the GND rail
7. Use a F-F jumper wire to connect the GND rail to GND on the Micro-SD card reader
8. Use a F-F jumper wire to connect the GND rail to GND on the relay board
9. Use a F-F jumper wire to connect the GND rail to GND on the display
10. Use a F-F jumper wire to connect the GND rail to GND on the ESP32
11. Use a F-F jumper wire to connect the 5V rail to 5V on the ESP32
12. Use a F-F jumper wire to connect the 5V rail to 5V on the Micro-SD card reader
13. Use a F-F jumper wire to connect the 5V rail to 5V on the relay board
14. Use a F-F jumper wire to connect GPIO23 (VSPI_MOSI) on the ESP32 to MOSI on the Micro-SD card reader
15. Use a F-F jumper wire to connect GPIO19 (VSPI_MISO) on the ESP32 to MISO on the Micro-SD card reader
16. Use a F-F jumper wire to connect GPIO18 (VSPI_CLK) on the ESP32 to SCK on the Micro-SD card reader
17. Use a F-F jumper wire to connect GPIO5 (VSPI_CS) on the ESP32 to CS on the Micro-SD card reader
18. Use a F-F jumper wire to connect GPIO22 (I2C_SCL) on the ESP32 to SCK on the display
19. Use a F-F jumper wire to connect GPIO21 (I2C_SDA) on the ESP32 to SDA on the display
20. Use a F-F jumper wire to connect 3.3V on the ESP32 to 3.3V on the display
21. Use a F-F jumper wire to connect GPIO32 on the ESP32 to CH1 on the relay board
22. Use a F-F jumper wire to connect GPIO33 on the ESP32 to CH2 on the relay board
23. Use a F-F jumper wire to connect GPIO25 on the ESP32 to CH3 on the relay board
24. Use a F-F jumper wire to connect GPIO26 on the ESP32 to the right side T2
25. Use a F-F jumper wire to connect GPIO27 on the ESP32 to the right side B2

Your prototyping board will look like so, however note that at this point on the photographs I have not plugged in the four wires of the display yet as I will do so when it comes to mounting in the project box out in the garage:

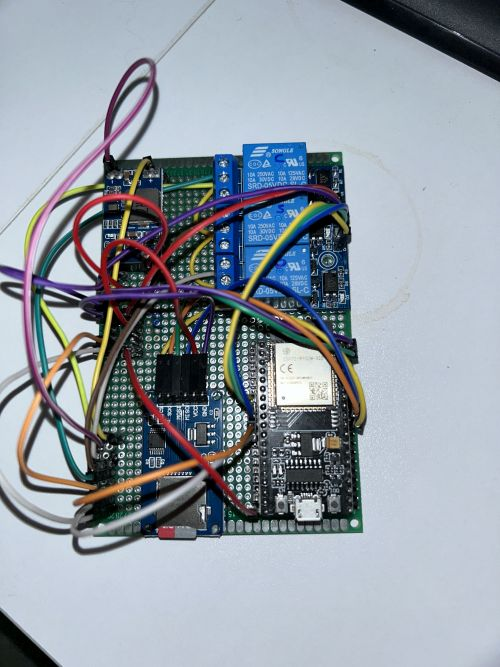
[picture p33: Pics/Assembly/Small/Assembly17.JPG]


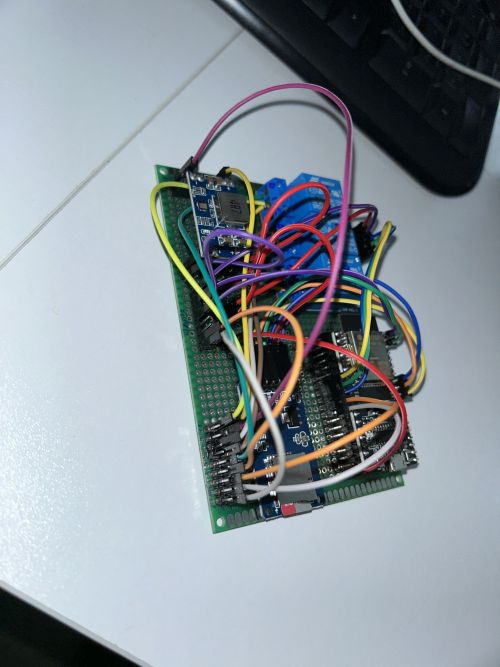
[picture p34: Pics/Assembly/Small/Assembly18.JPG]


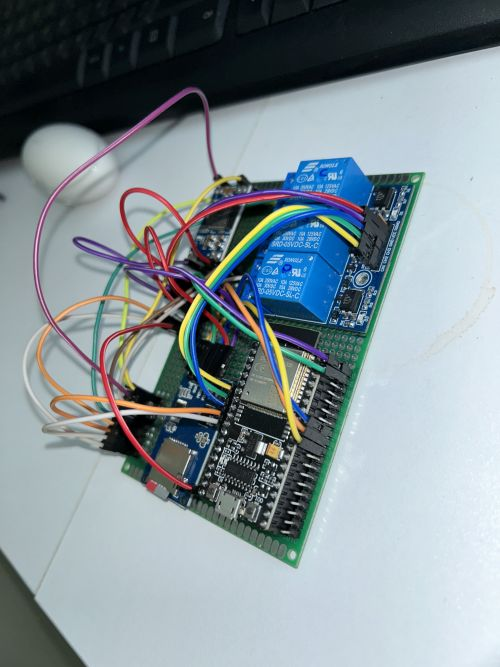
[picture p35: Pics/Assembly/Small/Assembly19.JPG]


The left side T1 and T2 pins of the interface port will connect to the top sensor and the left side B1 and B2 pins of the interface port will connect to the bottom sensor.  The left side 12V, GND, U, S and D pins will connect to the equivalents on the Glidermatic.

### Glidermatic Interface Cable
Finally, we need some cables.  First, lets make the one which will interface to the Glidermatic.  Cut a length of cable suitable to reach between your Glidermatic and the where you will place the project.  Take into account things such as clipping to walls, working around things, along roof space, and the like.  When you are happy, strip back the outer sheath 5cm and trim back 1cm from each of the five wires inside.  Fold them back on each other and twist them.  This will double the amount of wire you can place into the screw terminal.  The Glidermatic side will look like something like this:

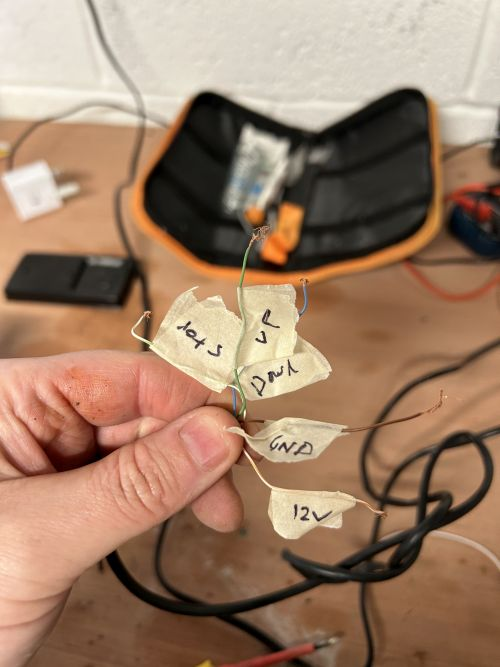
[picture p36: Pics/Assembly/Small/InterfaceGlidematicSide.JPG]


And, this is a nasty approach and you are welcome to improve on it, I did the same on the other side, but this time trimming 7cm outer sheath and 3cm inner but I also cut off the ends of five F-F jumper wires, trimmed the sheath back the same way and twisted them with each of the five wires in the cable.  Finally, I used heat-shrink on each each individually to complete.  You could use black electrical tape.

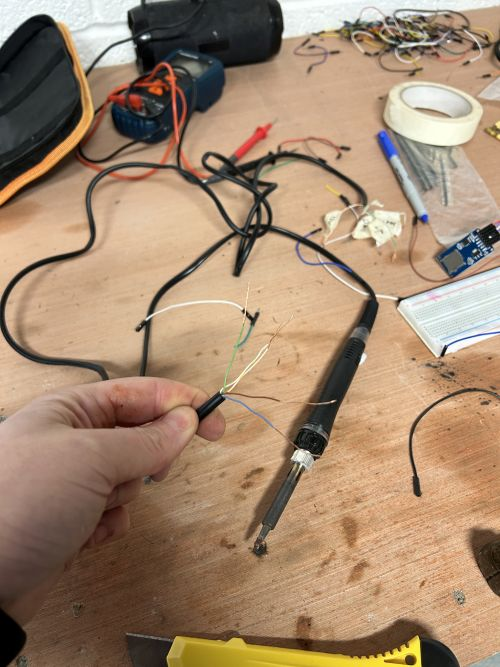
[picture p37: Pics/Assembly/Small/InterfaceGliderol2MQTTSide1.JPG]


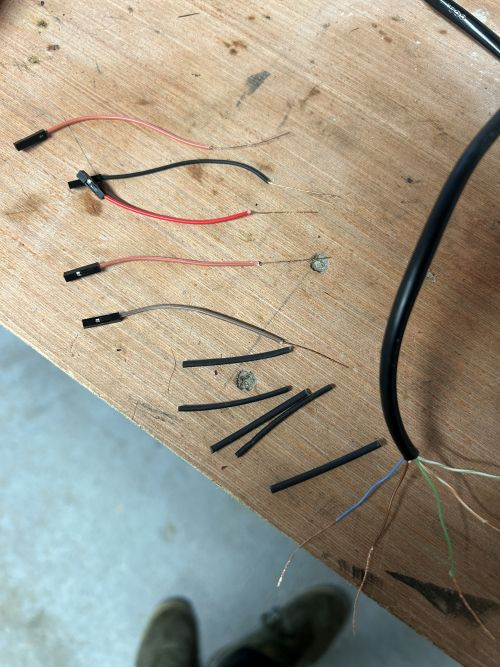
[picture p38: Pics/Assembly/Small/InterfaceGliderol2MQTTSide2.JPG]


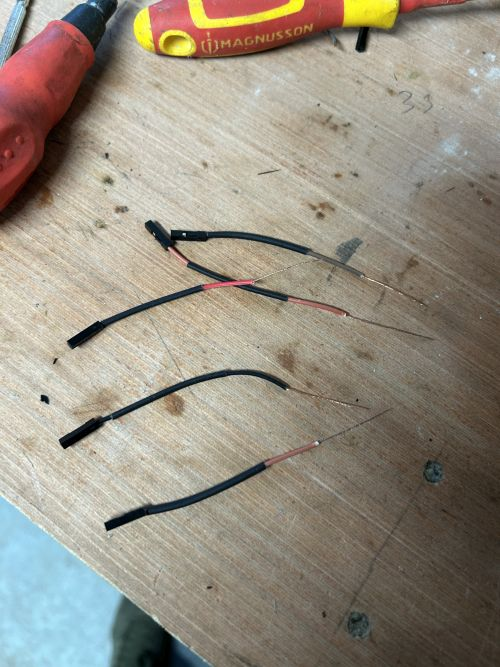
[picture p39: Pics/Assembly/Small/InterfaceGliderol2MQTTSide3.JPG]


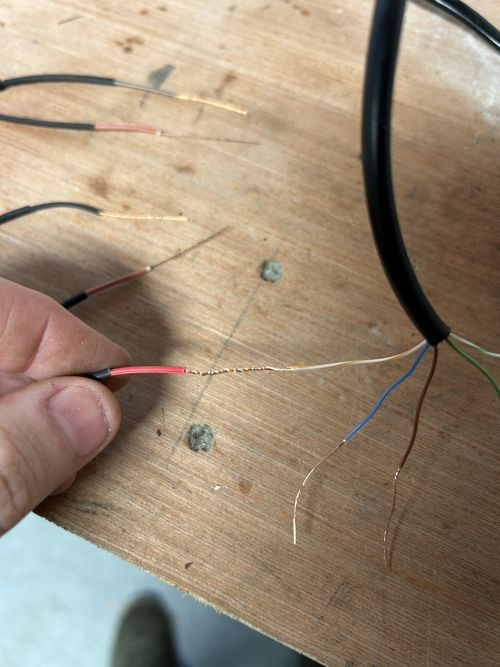
[picture p40: Pics/Assembly/Small/InterfaceGliderol2MQTTSide4.JPG]


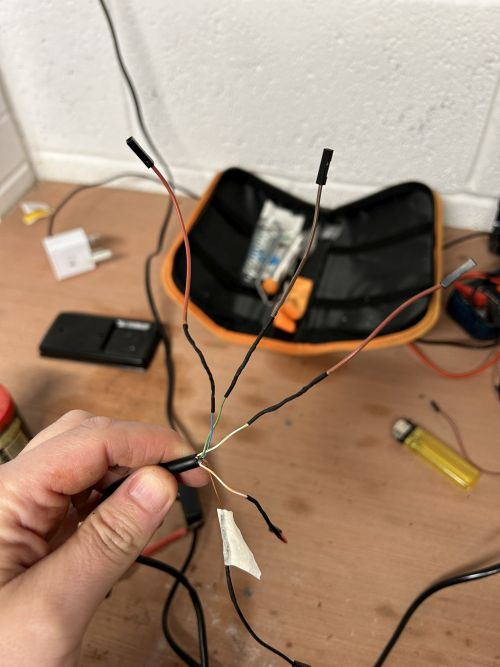
[picture p41: Pics/Assembly/Small/InterfaceGliderol2MQTTSide5.JPG]


I thought to put screw terminals on the Gliderol2MQTT but I wanted some quick flexibility to plug/unplug.  Perhaps you can get a cheap tool to crimp female jumpers to the end of wires, but that was beyond what I needed.  Use a little bit of masking tape on each of the five cores on each side to identify 12V, GND, U, S, D.  You are free to use whatever colours you choose.

The two ends should look like this:

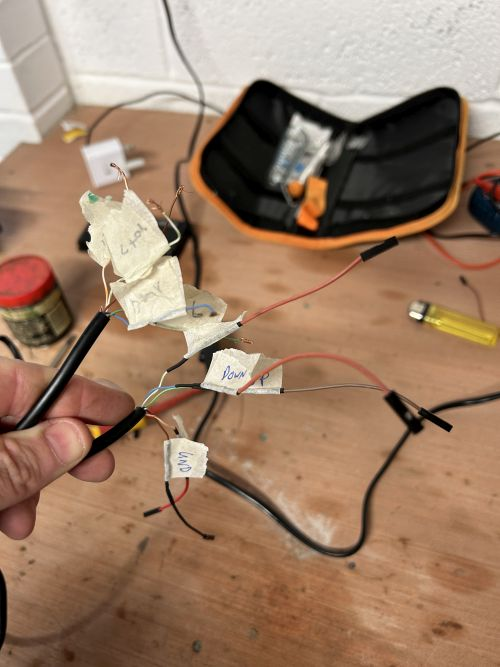
[picture p42: Pics/Assembly/Small/InterfaceGliderol2MQTTSide6.JPG]


Open the Glidermatic, identify the five screw terminals and screw in each of the five wires.  For the avoidance of doubt 12V goes to 12, GND to G, U to the Up arrow, S to the square and D to the Down arrow.  Put the cover back on the Glidermatic, and tack/fasten the wire up roughly to where you will be putting your Gliderol2MQTT.  As my project box will be next to the Glidermatic, I cable tied the interface cable to the Glidermatic power cable.  Leave the other end free standing for now.  Don't kill yourself, turn off the power and be sure.

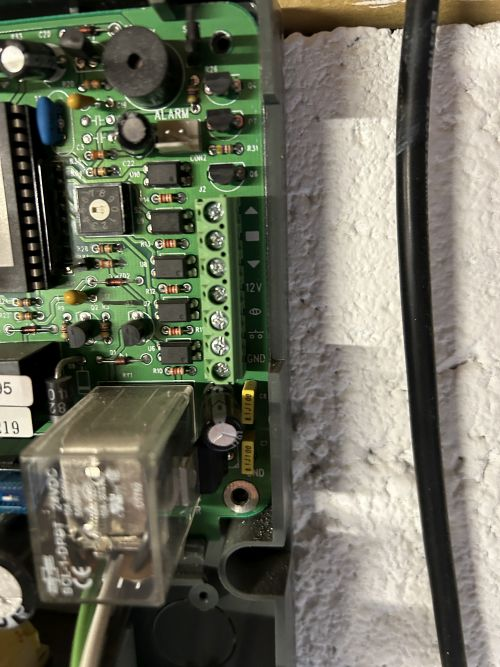
[picture p43: Pics/Assembly/Small/GlidematicPort.JPG]


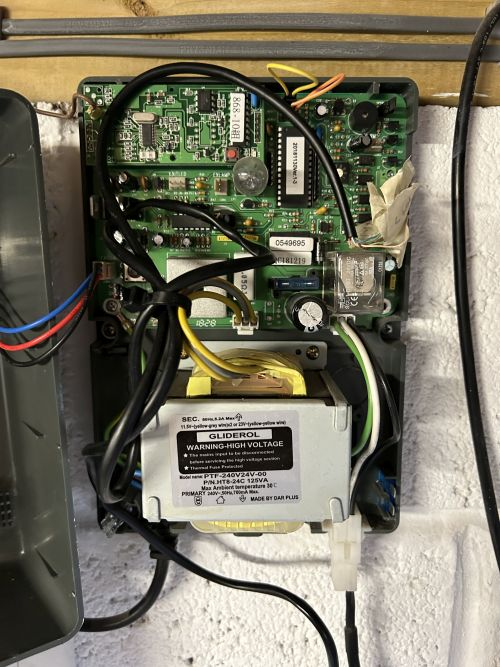
[picture p44: Pics/Assembly/Small/GlidematicWired.JPG]


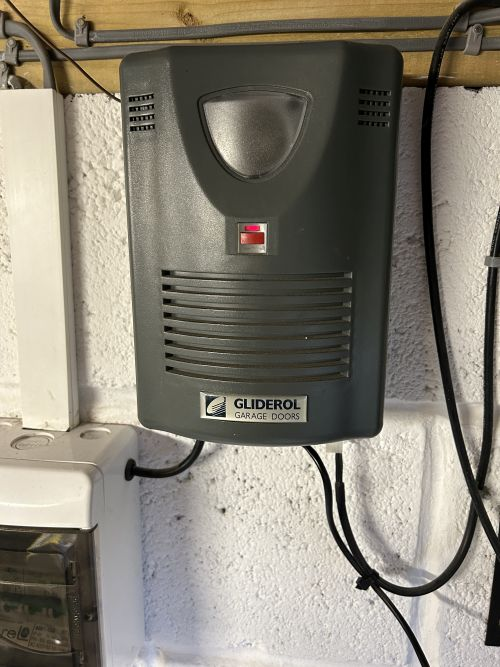
[picture p45: Pics/Assembly/Small/Glidematic.JPG]


### Bottom Sensor Cable
This cable just acts as a switch to sever (open) or complete (close) a circuit.  Measure a length of cable from where the floor sensor will go back to the Gliderol2MQTT's future home.  Again, pay respects to how you will route the cable back.  Strip back 3cm of outer sheath and trim back 1cm from each of the two wires inside.  Fold them back on each other and twist them.  In a similar nasty approach, leverage two F-F jumper wires and connect two to one side of the cable.  The cable will plug onto B1 and B2 of the Gliderol2MQTT of the Gliderol2MQTT.

It will look something like this (the blue ones):

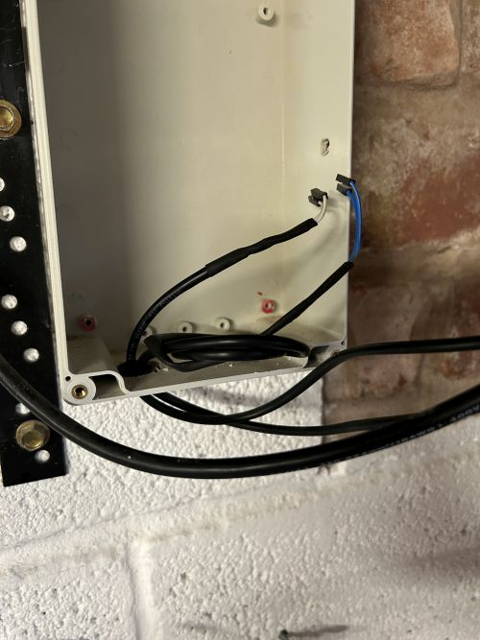
[picture p46: Pics/Assembly/Small/ProjectBoxSensorWiresReady.JPG]


It is worth noting the floor sensor may come with a metal sheath and a cable with a connector.  I employed my usual nastiness and hacked off the connector to expose the two wires.  Twist each of the wires in the cable you have just made to the exposed wires, heat shrink or tape the inner cores and finally heat shrink or tape over the outer sheaths.  The colouring and match doesn't matter.  It will look like this:

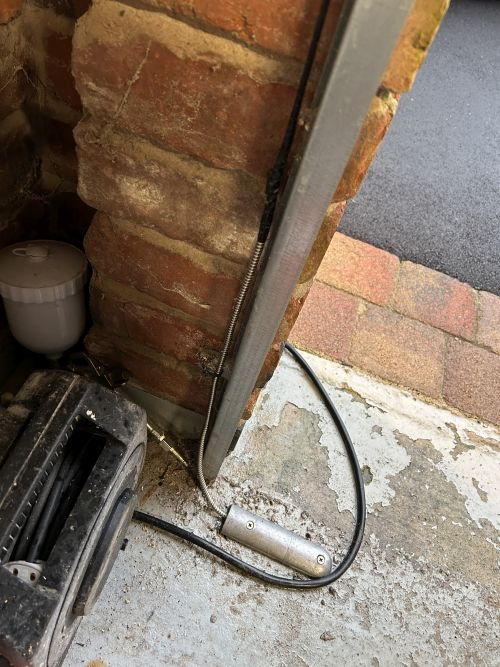
[picture p47: Pics/Assembly/Small/FloorSensor.JPG]


Install the floor sensor by drilling a couple of holes in the floor, snug sized wall plugs and screws.  Tack the cable appropriately up to where your Gliderol2MQTT will be housed.  Leave the other end free for now, we will plug that in to finish.  Fasten the magnetic block to your garage door.  I found it screwed and sat beautifully with my garage door.  It looks like this for me:

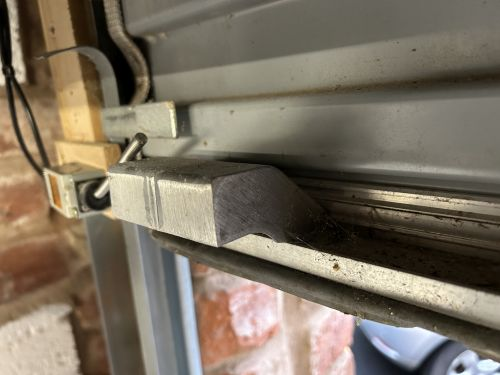
[picture p48: Pics/Assembly/Small/DoorMagnet1.JPG]


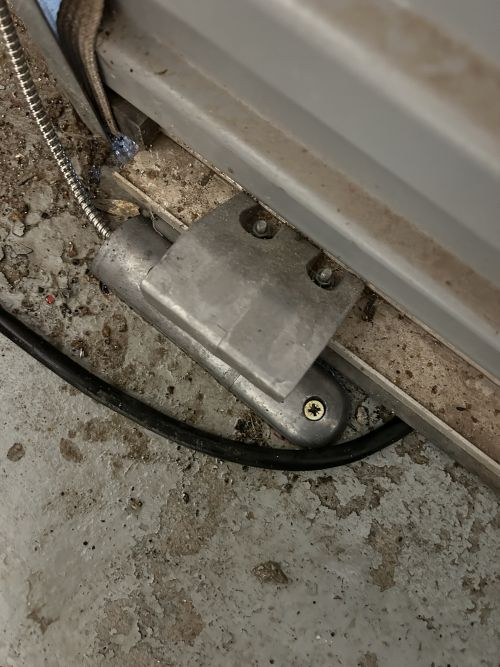
[picture p49: Pics/Assembly/Small/FloorSensorAndDoorMagnet1.JPG]


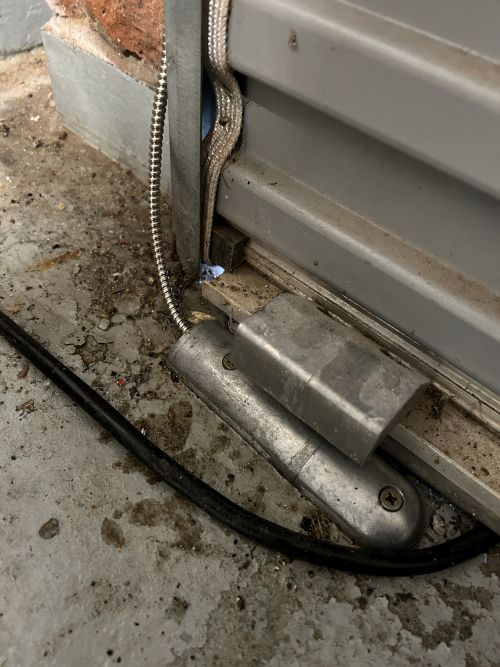
[picture p50: Pics/Assembly/Small/FloorSensorAndDoorMagnet2.JPG]


### Top Sensor Cable
This cable just acts as a switch to sever (open) or complete (close) a circuit.  Measure a length of cable from where the top sensor will go back to the Gliderol2MQTT's future home.  Again, pay respects to how you will route the cable back.  Strip back 3cm of outer sheath and trim back 1cm from each of the two wires inside.  Fold them back on each other and twist them.  In a similar nasty approach, leverage two F-F jumper wires and connect two to one side of the cable.  The cable will plug onto T1 and T2 of the Gliderol2MQTT of the Gliderol2MQTT.

It will look something like this (the white ones):



The top sensor has four terminals.  Two for Normally Closed (NC) and two for Normally Open (NO).  We want to connect our two cables to the Normally Open pair.  That is, the circuit is not complete unless the spring is bent.  It doesn't matter which of the two wires you screw to the terminals.  Just use the NO pair.

Install the top sensor by appropriately installing a bracket to be screwed in a position which will allow the spring to bend when the magnet block you have just installed comes up when the door has fully opened.  Be sure to check my video for how this works in practice if you are unsure.  Tack the cable appropriately up to where your Gliderol2MQTT will be housed.  Leave the other end free for now, we will plug that in to finish.  It looks like this for me:

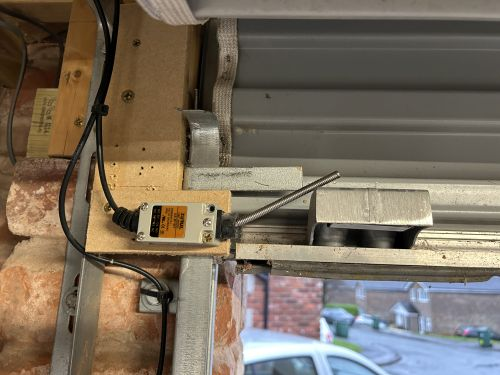
[picture p51: Pics/Assembly/Small/SpringActuator.JPG]


### Project Box and Mounting
Finally, fix your project box to the wall.  Before you do, decide if you are affixing a backplate (I used a small sheet of 6mm MDF) to the box and if this affects your mounting.  You could affix a back plate with hot melt glue or you can screw it through.  I would recommend you do this first before mounting to the wall.  It looks like this for me:

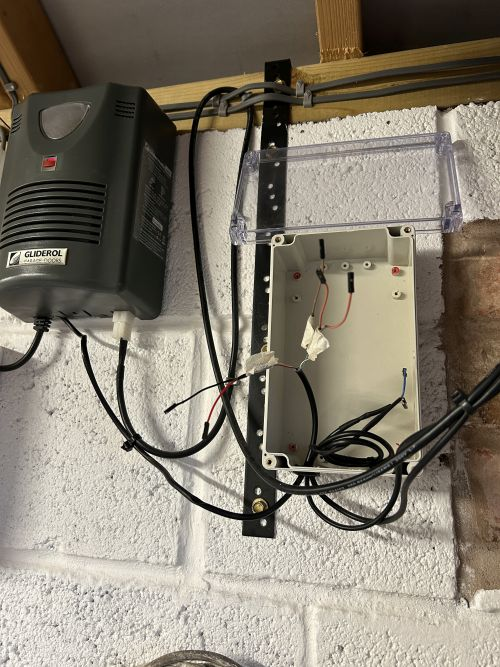
[picture p52: Pics/Assembly/Small/ProjectBoxAllWiresReady.JPG]


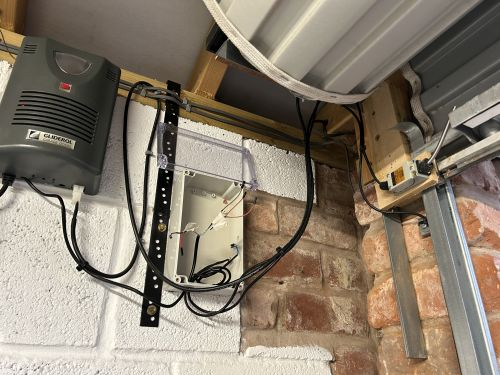
[picture p53: Pics/Assembly/Small/ProjectBoxAndGlidematicReady.JPG]


When we have finished programming the ESP32 and made sure everything behaves as well as to be expected without sensors and switches connected, we will screw the prototyping board to the backplate using some short self-tapping screws with washers.  We will affix to the project box and plug in the final wires.

# Programming
Gliderol2MQTT is built with [PlatformIO](https://platformio.org/) in Visual Studio Code.

## Software Setup
1. Install [Visual Studio Code](https://code.visualstudio.com/) and its **PlatformIO IDE** extension.
2. If your ESP32 board uses a CH340 USB chip and your computer doesn't recognise it, install the [Wemos CH340 Driver](https://www.wemos.cc/en/latest/ch340_driver.html).
3. Open the Gliderol2MQTT folder in VS Code (File / Open Folder).  PlatformIO downloads the ESP32 toolchain and all the libraries it needs automatically on the first build.

## Credentials
Copy `include/secrets.h.example` to `include/secrets.h` and fill in your WiFi details, your MQTT broker's address, port, username and password, and a password of your choosing for over-the-air updates.  `secrets.h` is git-ignored, so your passwords never end up in the repository.

## Configuration
Open `include/Definitions.h` and verify/customise the following for your needs:
```
- Set DEVICE_NAME to a different name if you wish.  NB: The device name is used as the MQTT base topic and presence on the network.  This is useful if you have more than two Glidermatics and wish to control all
- Set USING_TOP_SENSOR to true if you are using the top sensor, otherwise change to false
- Set TIME_TO_FULLY_OPEN_FROM_FULLY_CLOSED to the number of milliseconds it takes your garage door to go from fully closed to fully open.  Essentially, start it opening and count how long before the top sensor clicks.  Add a second or two for tolerance.  Gliderol2MQTT reports Opening until the top sensor confirms the door has arrived (or, without a top sensor, for this period of time)
- Set TIME_TO_FULLY_CLOSED_FROM_FULLY_OPEN to the number of milliseconds it takes your garage door to go from fully open to fully closed.  Essentially, start it closing and count how long before it reaches the bottom.  Add a second or two for tolerance.  Gliderol2MQTT reports Closing until the bottom sensor confirms the door has arrived
- Set RELAY_ACTIVE_LEVEL to the ESP32 pin level which switches your relays on.  HIGH (the default) if your relay board is active-high, i.e. a relay clicks on when it receives 3.3V; LOW if it is active-low, i.e. a relay clicks on when its input is pulled to GND.  (Older versions used a NORMALLY_OPEN / NORMALLY_CLOSED pair; NORMALLY_OPEN is still accepted on the SD card and means the same thing.)
- Set BOOT_UP_TARGET_STATE to 0 if you want, on boot up, Gliderol2MQTT to leave the last known retained target state in the MQTT broker as is (default), set to 1 if you wish to post a target state of Closed on boot up or set to 2 if you wish to post a target state of Open on boot up.
```

## First Upload
Plug the ESP32 in over USB, choose the `nodemcu-32s` environment in the VS Code status bar and press Upload (the arrow in the status bar).  After this first upload, future updates can be sent over WiFi - see [Over-the-air (OTA) updates](#over-the-air-ota-updates).

After uploading, you should see activity on your screen.  Like so:

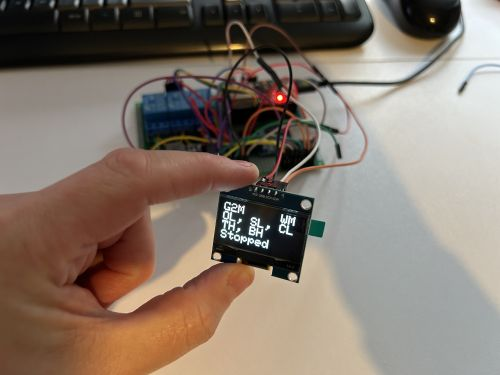
[picture p54: Pics/Assembly/Small/OnBenchWithDisplay.JPG]


Ideally it will connect to WiFi (confirming those details are right) and connect to MQTT (confirming those details are right) and you should be left with a screen which shows, in effect, a garbage garage door status.  You should see periodic messages on your MQTT broker.  I suggest using [MQTT Explorer](https://mqtt-explorer.com/).  Try posting an MQTT message to each of the Set Target, Open, Close and Stop topics to ensure the correct relay flashes/clicks.  If everything works, great!  Congratulations.  You are ready to take out to the garage for final setup.

## Using the Micro-SD card for configuration changes
All the settings you configured in Definitions.h earlier can be put into a text file so that they can be used.  This is useful if several months (or years) pass and you need to update your WiFi or MQTT details, etc.  Use the smallest and cheapest second hand Micro-SD card you can find.  Format it to FAT32 if it isn't already and create an empty text file called settings.txt on it.  Open settings.txt in a text editor and paste the following:
```
{
	"WIFI_SSID":"YourWiFiSSIDHere",
	"WIFI_PASSWORD":"YourPasswordHere",
	"MQTT_SERVER":"192.168.1.135",
	"MQTT_PORT":1883,
	"MQTT_USERNAME":"Garage",
	"MQTT_PASSWORD":"DoorOpener1",
	"DEVICE_NAME":"Gliderol2MQTT",
	"USING_TOP_SENSOR":"Yes",
	"TIME_TO_FULLY_OPEN_FROM_FULLY_CLOSED":10000,
	"TIME_TO_FULLY_CLOSED_FROM_FULLY_OPEN":10000,
	"RELAY_ACTIVE_LEVEL":"HIGH",
	"BOOT_UP_TARGET_STATE":0
}
```
Every setting is optional - anything left out keeps its compiled-in default.  The file must be valid JSON (watch out for a stray comma after the last entry); if it isn't, the screen shows `SETTINGS / BAD JSON` and none of it is used.  An individual value which is invalid (e.g. a port of 70000) is skipped and the rest still apply.  WiFi names and passwords may contain any characters, including spaces and symbols.  Older cards using `NORMALLY_OPEN`/`NORMALLY_CLOSED` instead of `RELAY_ACTIVE_LEVEL` still work.

The absence of a Micro-SD card or absence of the settings.txt file will just result in Gliderol2MQTT using the defaults you have burned into the ESP32 as part of the initial programming.  The Micro-SD card is required at all times, that is, the results aren't burned into the ESP32's limited flash memory.  Doing so would create further issues downstream, i.e. how to clear them, etc.

## Over-the-air (OTA) updates
Once Gliderol2MQTT firmware with OTA support has been flashed over USB *once*, every later update can be sent over WiFi - no need to visit the garage.

1. Make sure `OTA_PASSWORD` is set in `include/secrets.h` (letters and digits only).  The firmware is built with it, and `scripts/ota_auth.py` passes the same password to the uploader, so it only lives in one place.
2. Flash over USB the first time using the `nodemcu-32s` environment.
3. From then on, select the `nodemcu-32s-ota` environment (VS Code status bar) and upload, or run:
```
pio run -e nodemcu-32s-ota -t upload
```
PlatformIO finds the device as `Gliderol2MQTT.local` (your DEVICE_NAME followed by `.local`).  If you change DEVICE_NAME, update `upload_port` in `platformio.ini` to match - or use the device's IP address instead.

During an update all relays are released, the OLED shows progress, and `connection_status` is published as `false`.  The device reboots into the new firmware when the upload completes.  OTA is available from roughly two seconds after boot, including during the "Determine status" wait and while trying to reach the MQTT broker, so a broker problem won't lock you out of remote flashing.

If `pio` isn't recognised in your terminal, use the PlatformIO terminal in VS Code (PlatformIO sidebar / Quick Access / Miscellaneous / New Terminal), or run `~/.platformio/penv/bin/pio`.

## Code Layout and Tests
```
include/Definitions.h     Compiled-in settings and pin assignments - start here
include/secrets.h         Your credentials (git-ignored; copy from secrets.h.example)
src/main.cpp              Wires everything together; owns the relays, sensors and WiFi
src/Settings.cpp          settings.txt on the SD card
src/MqttInterface.cpp     MQTT connection, every topic (in one table) and its handler
src/Display.cpp           OLED, screen timeout and wake button
src/Ota.cpp               Over-the-air updates
src/BootReport.cpp        The device/boot report
lib/DoorLogic/            The door state machine, debouncing and command guard - no hardware code, so it is unit tested
test/test_door/           Those unit tests
scripts/ota_auth.py       Passes OTA_PASSWORD to the uploader
```
The door logic tests run on your computer, not the ESP32, in a few seconds:
```
pio test -e native
```
Run them before flashing a change to the door logic.

# Final Assembly
Affix your prototyping board to the backplate of your project box.

My implementation looks like so:

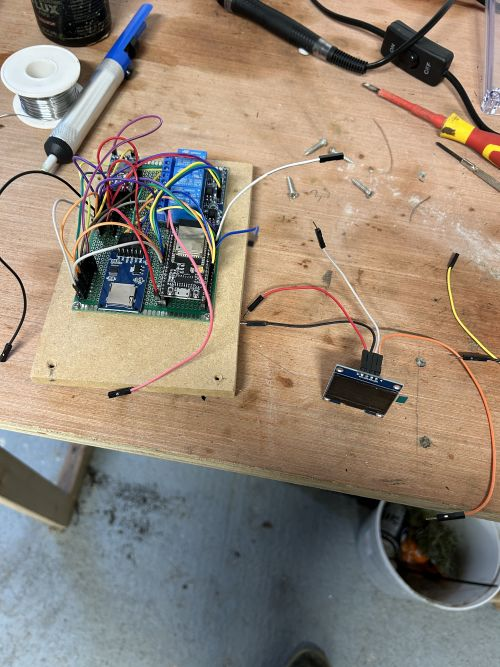
[picture p55: Pics/Assembly/Small/OnBenchWithDisplay2BackBoard.JPG]


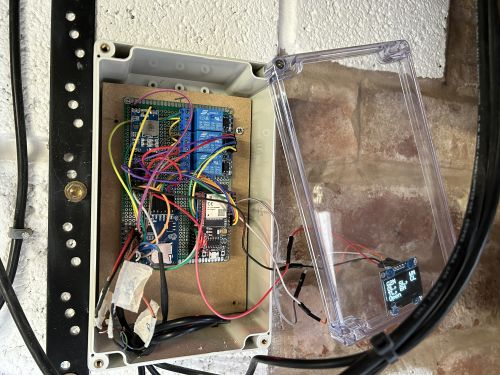
[picture p56: Pics/Assembly/Small/InProjectBox1.JPG]


Connect the five wires inside your interface cable (12V, GND, U, S, D) to the equivalent left side pins on the interface port on your prototyping board.  Finally, connect the two bottom sensor wires from your bottom sensor cable to the left side B1 and B2 on your prototyping board.  Order doesn't matter.  Repeat for the top sensor to T1 and T2 respectively if you are using the top sensor.  Meanwhile I glued the display to the front of the project box and connected up four M-F jumper wires so that the front cover of the project box could be easily removed/affixed in the future, but you could just use long F-F jumper wires to same effect and tuck them away.

And finally the display jumper wires.
1. Use a F-F jumper wire to connect 3.3V from the ESP32 to VCC on the display
2. Use a F-F jumper wire to connect the GND rail to the GND input on the display
3. Use a F-F jumper wire to connect GPIO21 (I2C_SDA) from the ESP32 to SDA on the display
4. Use a F-F jumper wire to connect GPIO22 (I2C_SCL) from the ESP32 to SCK on the display

You can press the reset button (bottom left) on the ESP32 to reboot it - because when you connect 12V and GND it will power on straight away.  Perhaps it would be sensible to put a little on/off switch on the 12V supply line?  Food for thought.

It will look like so, to give you a finished product.

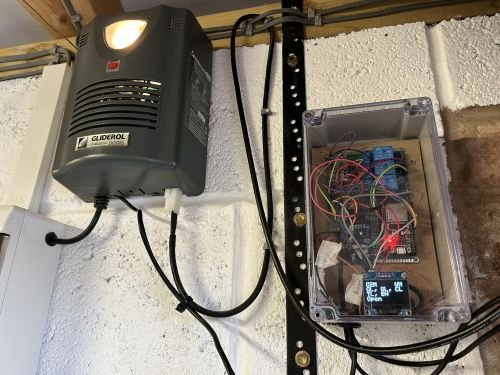
[picture p57: Pics/Assembly/Small/Finished1.JPG]




Test that all the sensors work by opening and closing the door using your fob or the button on the Glidermatic.  You should see the screen alter between Open / Opening / Closed etc.  Have an MQTT explorer nearby so you can validate the target and current states are getting posted out.  Have a play sending Open / Close / Stop messages to the device to see it in action.

Debug any unexpected or features which aren't working.

Best of luck!

# OLED Screen
Here's what the various things on the OLED screen tell you:

## Screen timeout and wake button
OLED screens dim and burn in according to how long their pixels are lit, so to make yours last, the screen switches itself off after two minutes with nothing happening (`DISPLAY_TIMEOUT_MS` in Definitions.h; set it to 0 to keep the screen on permanently).  It switches back on by itself at boot, whenever the door changes state, when WiFi or MQTT connects or drops, and during an OTA update or reboot.  It stays on for as long as WiFi or MQTT is down, so a problem is always visible.

You can also fit an optional push button to wake it on demand - handy on the outside of the project box.  Use a normally-open (momentary) push button wired between **GPIO4** and **GND**.  No resistor is needed (the ESP32's internal pull-up is used), and if no button is fitted nothing happens.  A brief press wakes the screen for another two minutes; holding the button keeps it on.

## Line 1
Status bar.  It will display G2M in the top left corner, and in the top right will show a flashing asterisk (*) to indicate normal operations, will show a steady W when WiFi is connected and a steady M when MQTT is connected.

## Lines 2, 3 and 4
Current status, depending on what that status is.

### SD Card Not Found or other failure regarding SD Card
```
NO SD CARD
Using
Defaults...
```

### settings.txt could not be used
Shown for four seconds if settings.txt isn't valid JSON (`BAD JSON`) or is larger than 4KB (`TOO BIG`).  The compiled-in defaults are used instead.
```
SETTINGS
BAD JSON
Defaults..
```

### Determining status
When the device first starts it will pause for the longer of the two durations specified for door open time or door close time.  This is because when the device is first powered on it has no reliable way to know where the door is - it could be turned on whilst the door is opening.  So it waits before it starts to report a known status
```

Determine
status...
```

### Connecting to WiFi and MQTT
Gliderol2MQTT no longer stops on a "Connecting" screen.  It connects in the background and carries on monitoring the door - so the screen keeps showing the live door state even during a WiFi or broker outage.  The W and M in the status bar show whether WiFi and MQTT are currently connected.

### Rebooting / OTA update
```
Rebooting
...
```
or, during an over-the-air update, `OTA / Updating / nn%`.

### Normal Operation
The normal operating screen contains indicators H or L depending on whether the relevant pin on the ESP32 is high or low.  I used it for debugging but in the absence of needing the screen to do much else, I left it in.  OH would indicate the OPEN relay is active (high) and OL would indicate the OPEN relay is inactive (low).  S is the STOP relay, C is the CLOSE relay, T is the top sensor (if used) and B is the bottom sensor.  The bottom line shows one of Open, Closed, Stopped, Opening, Closing depending on what the door is doing.
```
O%s, S%s, C%s
T%s, B%s
%s
```

For example, if you were to look at the screen the moment you instructed Gliderol2MQTT to close the door, the screen would likely show the following:
```
OH, SL, CL
TL, BL
Closing
```
And when the door has shut, you may see:
```
OL, SL, CL
TL, BH
Closed
```

# Interfacing with Smart Homes
For reference:
1. I use a Raspberry Pi Model 4b (4Gb) running Raspberry Pi OS.
2. I installed Mosquitto MQTT broker on it and configured it accordingly.
3. I installed Homebridge on it and configured it accordingly.
4. I installed Docker on it, and installed Home Assistant in a docker container.

- Be sure to give the device running Homebridge a static IP in your router.  The last thing you want is Gliderol2MQTT going offline because you restarted your Raspberry Pi (or other device) and your router handed out a different IP to it.
- You can always open up Homebridge to the outside world by letting port 8581 through your router to your device.
- You can always open up Home Assistant to the outside world by letting port 8123 through your router to your device.

## Interfacing with Homebridge

### Installing Homebridge
Homebridge can be installed on a Raspberry Pi (on top of Raspberry Pi OS or as a standalone system) or other small factor PC you don't mind leaving always-on.  It can be installed under other operating systems such as Windows using a virtual machine.  Homebridge acts a software based HomeKit, making your home a Smart Home (in Apple's eyes anyway) and enables devices unsupported by Apple (such as the Gliderol2MQTT you've just made!) to speak to your new Smart Home.

Install it from [here](https://homebridge.io/)

### Installing and Configuring Homebridge MQTT-Thing
When your Homebridge is up and running, navigate to the Plugins tab at the top and search for **Homebridge MQTT-Thing-EX** (`homebridge-mqttthing-ex`) - the maintained fork of the original MQTT-Thing plugin, which is no longer developed.  This is the nifty plugin which will take what Gliderol posts out and allows your Apple Home to display it.  It also takes the requests from your Apple Home (App or Siri Instruction) to open or close the door.

When it is installed, it will appear in your list of installed plugins.  Press the cog at the bottom right of the MQTT-Thing plugin and choose Config.  Click + to add a device.  We will be adding a Garage Door Opener.

Configure it as so
```
Name: Garage Door
MQTT Url: mqtt://localhost:1883 (You will need to point this to your MQTT Broker)
MQTT Username: The username Mqttthing will use to connect in to your broker
MQTT Password: The password Mqttthing will use to connect in to your broker
Log MQTT: Yes
Keep Alive: 0
MQTT Topic - Set Target Door State: Gliderol2MQTT/set/target/door/state
MQTT Topic - Get Target Door State: Gliderol2MQTT/get/target/door/state
MQTT Topic - Get Current Door State: Gliderol2MQTT/get/current/door/state
MQTT Topic - Get Online: Gliderol2MQTT/connection_status
Advanced - Confirmation Period (ms): 1000
Advanced - Confirmation Retry Limit: 3
Advanced - Confirmation Indicate Offline: Yes
Advanced - Online Value: true
Advanced - Offline Value: false
```

Alternatively, if you want the JSON config to paste straight in, click the cog at the bottom right of the MQTT-Thing-EX plugin and choose JSON Config, and use the following.  Don't forget to modify to suit:
```
{
    "platform": "mqttthing-ex",
    "devices": [
        {
            "type": "garageDoorOpener",
            "name": "Garage Door",
            "url": "mqtt://localhost:1883",
            "username": "YOUR_MQTT_USERNAME",
            "password": "YOUR_MQTT_PASSWORD",
            "logMqtt": true,
            "topics": {
                "getOnline": "Gliderol2MQTT/connection_status",
                "getCurrentDoorState": "Gliderol2MQTT/get/current/door/state",
                "getTargetDoorState": "Gliderol2MQTT/get/target/door/state",
                "setTargetDoorState": "Gliderol2MQTT/set/target/door/state"
            },
            "onlineValue": "true",
            "offlineValue": "false",
            "confirmationIndicateOffline": true
        }
    ]
}
```
HomeKit occasionally sends the same command twice in quick succession; Gliderol2MQTT recognises a repeat within two seconds and doesn't press the Glidermatic button a second time.

When you open the Home app on your iPhone it will detect the presence of your garage door and invite you to add it to your home.  Do so.  You can then control the garage door.

This yields the following dashboard in Homebridge which you can control from your browser:

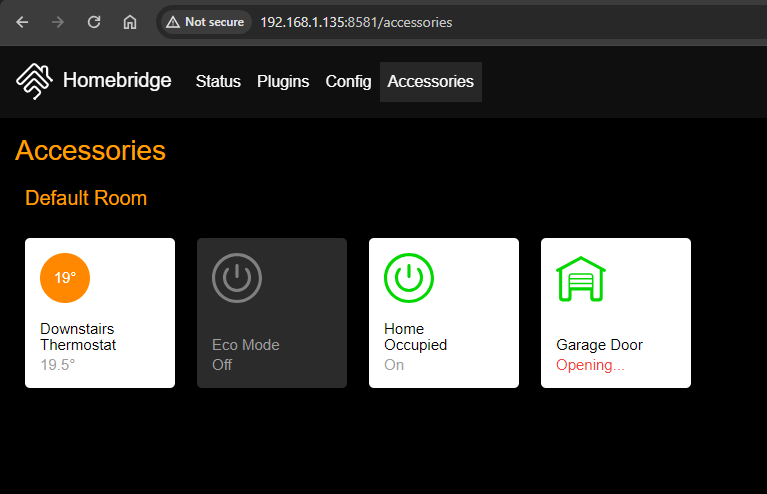
[picture p58: Pics/HomebridgeAccessories.PNG]


And the following in your Apple Home app:

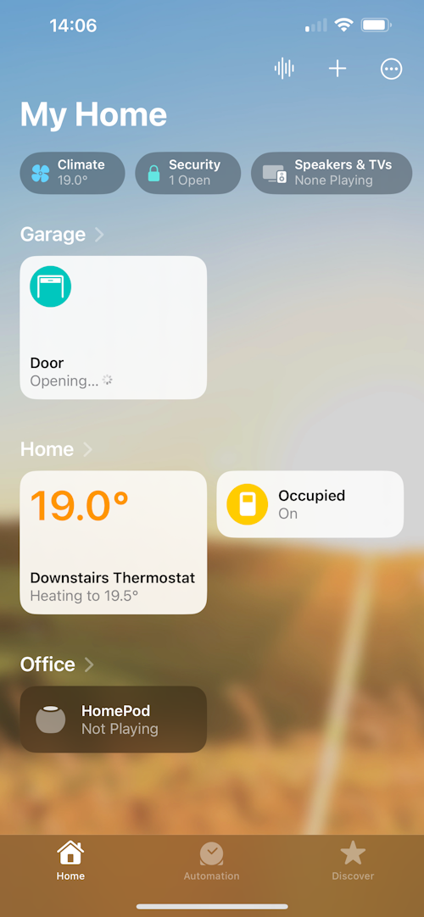
[picture p59: Pics/AppleHome.PNG]


### Accessing your home when away from home.
To allow your Apple iPhone's Home app (or Apple Watch) to access your home when you are away from home, you have no option other than to buy a device which provides an external bridge.  A second hand HomePod Mini (£40 or so) configured in your Home is all you need.  It does not require any additional configuration, it is all handled through Apple's configuration and servers.  Other devices include the HomePod, or the later Apple TV models.

## Interfacing with Home Assistant
### Installing Home Assistant
Home Assistant can be installed on a Raspberry Pi (on top of Raspberry Pi OS or as a standalone system) or other small factor PC you don't mind leaving always-on.  It can be installed under other operating systems such as Windows using a virtual machine.  Home Assistant is a great way to make your very own Smart Home.

Install it from [here](https://www.home-assistant.io/)

### Configuring Home Assistant
**Nothing to configure.**  Gliderol2MQTT uses Home Assistant's MQTT discovery: as long as Home Assistant's MQTT integration is connected to the same broker, a **Gliderol2MQTT** device appears automatically (Settings / Devices & Services / MQTT) with:
- **Door** - a garage door with Open, Close and Stop, showing Open / Opening / Closed / Closing
- **Reboot** - a button which reboots Gliderol2MQTT
- **WiFi signal**, **Free memory**, **Last boot** and **Last reset reason** - diagnostic sensors

To turn discovery off, set `HOME_ASSISTANT_DISCOVERY` to false in Definitions.h.

### Manual Home Assistant configuration
Only needed if you have turned discovery off.  (If you configured Gliderol2MQTT by hand before discovery existed, either remove this YAML or turn discovery off, otherwise you'll see each entity twice.)  To get functional garage door in Home Assistant, I have created the following entities you should add to your configuration.yaml:
```
mqtt:
  - button:
      unique_id: Gliderol2MQTT_Button_Open
      name: "Gliderol2MQTT Open"
      command_topic: "Gliderol2MQTT/request/perform/open"
      payload_press: ""
      availability:
        - topic: "Gliderol2MQTT/connection_status"
          payload_available: "true"
          payload_not_available: "false"
      qos: 0
      retain: false
      icon: mdi:menu-up
  - button:
      unique_id: Gliderol2MQTT_Button_Stop
      name: "Gliderol2MQTT Stop"
      command_topic: "Gliderol2MQTT/request/perform/stop"
      payload_press: ""
      availability:
        - topic: "Gliderol2MQTT/connection_status"
          payload_available: "true"
          payload_not_available: "false"
      qos: 0
      retain: false
      icon: mdi:square-medium
  - button:
      unique_id: Gliderol2MQTT_Button_Close
      name: "Gliderol2MQTT Close"
      command_topic: "Gliderol2MQTT/request/perform/close"
      payload_press: ""
      availability:
        - topic: "Gliderol2MQTT/connection_status"
          payload_available: "true"
          payload_not_available: "false"
      qos: 0
      retain: false
      icon: mdi:menu-down
  - sensor:
      unique_id: Gliderol2MQTT_State
      name: "Gliderol2MQTT State"
      state_topic: "Gliderol2MQTT/get/current/door/state"
      device_class: enum
      availability:
        - topic: "Gliderol2MQTT/connection_status"
          payload_available: "true"
          payload_not_available: "false"
      icon: mdi:garage
  - sensor:
      unique_id: Gliderol2MQTT_Connection_Status
      name: "Gliderol2MQTT Connection Status"
      state_topic: "Gliderol2MQTT/connection_status"
      device_class: enum
      icon: mdi:garage

template:
  - sensor:
      - unique_id: Gliderol2MQTT_Overall_State
        device_class: enum
        name: "Gliderol2MQTT Overall State"
        state: >
          {% if is_state("sensor.gliderol2mqtt_state", "o") %}
            Opening
          {% elif is_state("sensor.gliderol2mqtt_state", "c") %}
            Closing
          {% elif is_state("sensor.gliderol2mqtt_state", "O") %}
            Open
          {% elif is_state("sensor.gliderol2mqtt_state", "C") %}
            Closed
          {% elif is_state("sensor.gliderol2mqtt_state", "S") %}
            Stopped
          {% elif is_state("sensor.gliderol2mqtt_connection_status", "false") %}
            Offline
          {% else %}
            Unknown
          {% endif %}
        icon: >
          {% if is_state("sensor.gliderol2mqtt_state", "o") %}
            mdi:garage-open
          {% elif is_state("sensor.gliderol2mqtt_state", "c") %}
            mdi:garage
          {% elif is_state("sensor.gliderol2mqtt_state", "O") %}
            mdi:garage-open
          {% elif is_state("sensor.gliderol2mqtt_state", "C") %}
            mdi:garage
          {% elif is_state("sensor.gliderol2mqtt_state", "S") %}
            mdi:garage-alert
          {% elif is_state("sensor.gliderol2mqtt_connection_status", "false") %}
            mdi:cloud-off-outline
          {% else %}
            mdi:exclamation
          {% endif %}
```

And finally, this is an example dashboard which you can paste into a new blank dashboard which will demonstrate the core functionality.
```
views:
  - title: Home
    cards:
      - type: entities
        entities:
          - entity: button.gliderol2mqtt_open
            name: Open
          - entity: button.gliderol2mqtt_stop
            name: Stop
          - entity: button.gliderol2mqtt_close
            name: Close
        title: Garage Door
        show_header_toggle: true
        state_color: false
      - type: vertical-stack
        cards:
          - type: entity
            entity: sensor.gliderol2mqtt_connection_status
          - type: entity
            entity: sensor.gliderol2mqtt_overall_state
            name: Garage Door Currently (Template)
          - type: entity
            entity: sensor.gliderol2mqtt_state
            name: Garage Door Currently
          - show_name: false
            show_icon: true
            type: button
            tap_action:
              action: toggle
            entity: button.gliderol2mqtt_open
            show_state: false
            icon_height: 100px
          - show_name: false
            show_icon: true
            type: button
            tap_action:
              action: toggle
            entity: button.gliderol2mqtt_stop
            icon_height: 100px
          - show_name: false
            show_icon: true
            type: button
            tap_action:
              action: toggle
            entity: button.gliderol2mqtt_close
            icon_height: 100px
```

This yields the following dashboard which you can control from your desktop or your mobile phone:

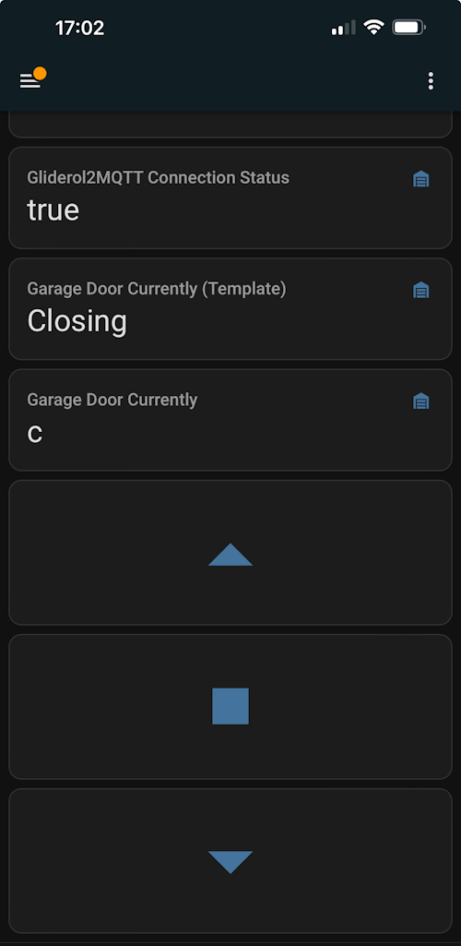
[picture p60: Pics/HADashboard.PNG]


### Accessing your home when away from home.
To allow your Home Assistant to be accessible away from home, consider using the [DuckDNS](https://www.home-assistant.io/integrations/duckdns/) integration to give your home Internet connection a consistent name accessible to the outside world, i.e. http://mysuperhome.duckdns.org.  Then simply install the Home Assistant App and point to your new name on the net.  All of Home Assistant will be available in your pocket.  You can even do notifications in Home Assistant when using their App to mimic the functionality of Apple Home.  You too could get a notification when your garage door is opened or closed.

# Gliderol2MQTT's Around The World
If you build your own Gliderol2MQTT, be sure to send me pictures of it in action so I can add it to this page!  I'd love to hear from you.

# Your Improvements
If you come up with any nifty developments in any home automation tool and would like them included here for the benefit of all, feel free to send me details, instructions, code samples or images and I will ensure they are added to this page with due credit.

# Version History
## v1.0
The original development took place during September and October 2022 and was ESP8266 based.
In December 2023 the project was re-written slightly and rebuilt for an ESP32.

2024-01-12 - Initial Release to public.

## v2.0
2026-11-07 - Refactored for platform.io in Visual Studio Code.

## v2.1
2026-11-07 - Major overhaul.
- Over-the-air (OTA) firmware updates.
- Safety: relays held released from power-on; retained MQTT commands can no longer act on reconnect; repeated commands don't press the button twice; sensors debounced.
- Door state is sensor-led: Open/Closed is reported the moment the destination sensor confirms it, with a grace period before Stopped.
- Keeps running through WiFi/broker outages, reconnecting in the background.
- SD card settings parsed with ArduinoJson (WiFi names and passwords may contain any characters); `RELAY_ACTIVE_LEVEL` replaces `NORMALLY_OPEN`/`NORMALLY_CLOSED`.
- New topics: `request/perform/reboot`, `device/boot`, `device/status`.
- Home Assistant MQTT discovery.
- Screen timeout and optional wake button to extend OLED life.
- Hang watchdog.
- Credentials in a git-ignored `include/secrets.h`.
- Code split into modules, with unit tests for the door logic (`pio test -e native`).
- MQTT replies are now compact JSON.

# Gliderol Credits
Gliderol / Glidermatic are trademarks of Gliderol Roller Doors Pty. Ltd.

https://www.gliderol.co.uk/

https://www.gliderol.com.au/
