dxoverdy/Gliderol2MQTT/SD Card/settings.txt

{
	"WIFI_SSID":"YourWiFiSSIDHere",
	"WIFI_PASSWORD":"YourWiFiPasswordHere",
	"MQTT_SERVER":"192.168.1.125",
	"MQTT_PORT":1883,
	"MQTT_USERNAME":"Garage",
	"MQTT_PASSWORD":"DoorOpener1",
	"DEVICE_NAME":"Gliderol2MQTT",
	"USING_TOP_SENSOR":"Yes",
	"TIME_TO_FULLY_OPEN_FROM_FULLY_CLOSED":10000,
	"TIME_TO_FULLY_CLOSED_FROM_FULLY_OPEN":10000,
	"RELAY_ACTIVE_LEVEL": "HIGH",
	"BOOT_UP_TARGET_STATE": 0
}
