dxoverdy/Gliderol2MQTT/Pics/Assembly/Assembly16.JPG

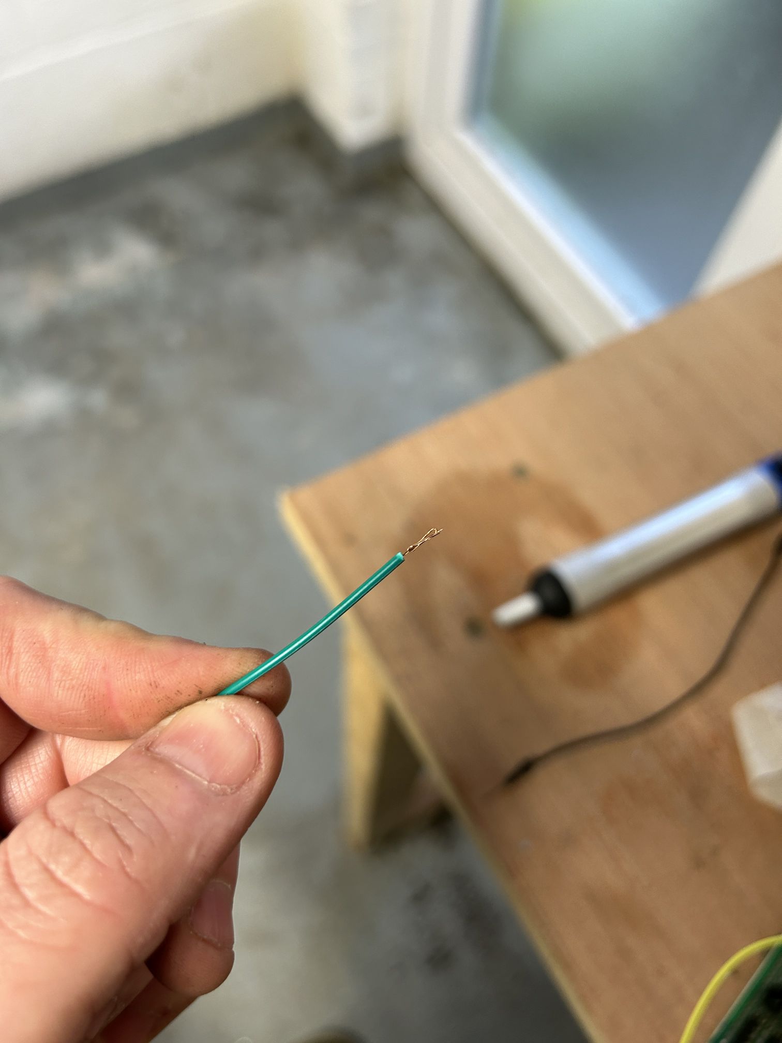
Pics/Assembly/Assembly16.JPG
