dxoverdy/Gliderol2MQTT/Pics/Schematic.pdf

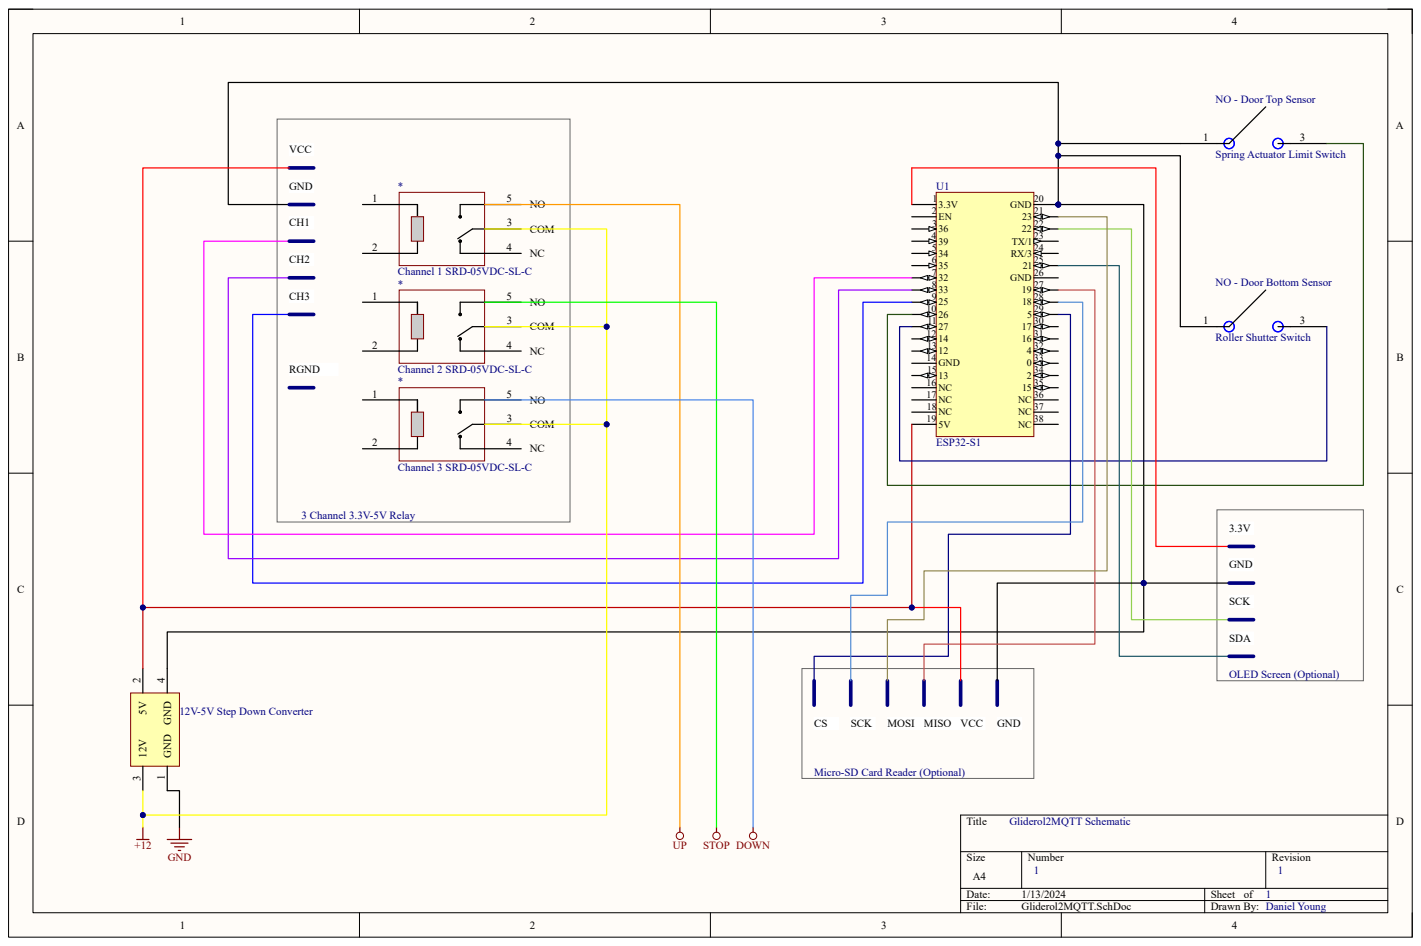
[picture p62: page 1]
Title; Size; Number; Revision; Date:; Sheet of; File:; Gliderol2MQTT.SchDoc; Drawn By:; 3.3V 1 EN 2 36 3 39 4 34 5 35 6 32 7 33 8 25 9 26 10 27 11 14 12 12 13 GND 14 13 15 NC 16 NC 17 NC 18 5V 19; GND 20 23 21 22 22 TX/1 23 RX/3 24 21 25 GND 26 19 27 18 28; ESP32-S1; COM 3; Channel 2 SRD-05VDC-SL-C; 3 GND; 2 GND; GND; STOP DOWN; 3 Channel 3.3V-5V Relay; VCC; RGND; SCK; SDA; MOSI MISO VCC GND; Gliderol2MQTT Schematic; Daniel Young

NO - Door Top Sensor

Spring Actuator Limit Switch

Channel 1 SRD-05VDC-SL-C 12V

NO - Door Bottom Sensor

Roller Shutter Switch

Channel 3 SRD-05VDC-SL-C

OLED Screen (Optional)

12V-5V Step Down Converter

Micro-SD Card Reader (Optional)
