dxoverdy/Gliderol2MQTT/(commit log)

2024-01-13 Schematic Update
2026-11-07 Phase 1 safety/bug fixes and over-the-air updates
    Safety:
    - Clear retained door commands before subscribing, and ignore door
    commands for 1.5s after subscribing, so a retained message can never
    actuate the door on reconnect
    - Bound the incoming MQTT payload copy (was a stack overflow)
    - Compile out the relay set/clear dev topics (ENABLE_DEV_TOPICS) and make
    them honour the configured relay polarity
    - Drive relay pins to released state as the very first thing in setup()
    - Debounce the door sensors (100ms) instead of delay(100)
    Bugs:
    - SD settings: reject oversized files, bound field copies, stop logging
    passwords
    - Pass String to sprintf via c_str(); replace overlapping sprintf with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
2026-11-07 Clarify relay polarity setting and tune MQTT intervals
    - Replace NORMALLY_OPEN/NORMALLY_CLOSED with a single RELAY_ACTIVE_LEVEL;
    the idle level is derived, so the two can no longer be set
    inconsistently. NORMALLY_OPEN is still accepted on the SD card.
    - MQTT keep-alive 5s -> 15s (library default): the broker waits 1.5x, so
    offline is reported after ~22s, and brief WiFi blips no longer fire
    the LWT or force a reconnect.
    - Periodic state publish 5s -> 60s, plus an immediate publish on every
    (re)connect, which covers a broker that lost its retained messages.
    - README and example settings.txt updated to match.
2026-11-07 Publish a retained boot report once per boot
    New BootReport module (include/BootReport.h, src/BootReport.cpp)
    publishes to <device>/device/boot after the first MQTT connect: NTP time
    (UTC), reset reason (power_on/external/software/crash/watchdog/brownout),
    persistent boot count (NVS), online_after_ms, version, firmware MD5, IP
    and MAC.
    The serial log now shows how long the "Determine status" wait lasted.
2026-11-07 Phase 2: ArduinoJson settings, non-blocking network, reboot topic
    Settings:
    - New Settings module (include/Settings.h, src/Settings.cpp) replacing
    the hand-written parser with ArduinoJson. Values are no longer
    stripped of characters (SSIDs with '-'/spaces, passwords with symbols
    now work), each value is validated and skipped individually if bad,
    quoted numbers and the legacy NORMALLY_OPEN key are still accepted,
    and invalid/oversized files are rejected whole (BAD JSON / TOO BIG on
    the OLED) so the defaults are used.
    - Settings live in one Settings struct instead of 13 globals.
    Non-blocking:
    - WiFi and MQTT are maintained from loop() without blocking: sensors
    and display stay l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
2026-11-07 Disable WiFi modem-sleep and report RSSI at boot
    Modem-sleep makes the ESP32 miss multicast traffic, so <device>.local
    (mDNS) stops resolving and OTA uploads by hostname fail; it also causes
    the 100-1000ms ping times seen. Power cost is irrelevant on 12V.
    The boot report now includes the WiFi signal strength (rssi, dBm).
2026-11-07 Screen timeout and optional wake button (GPIO4)
    OLED wear is proportional to lit time, so the display now sleeps after
    DISPLAY_TIMEOUT_MS (2 min) of inactivity. It wakes on boot, door state
    changes, WiFi/MQTT connecting or dropping, OTA and reboot, and stays on
    while WiFi or MQTT is down.
    A normally-open button between GPIO4 and GND (internal pull-up, 30ms
    debounce) wakes it on demand; holding it keeps the screen on.
    readDebounced() now takes the debounce time as a parameter.
2026-11-07 Sensor-led door movement: finish on arrival, grace before Stopped
    Seen in Homebridge logs: a door reaching the top switch at ~10.5s
    against a 10s setting reported o -> S -> O within a second.
    - A movement now ends as soon as the destination sensor confirms
    arrival (top sensor for opening, bottom sensor for closing) instead
    of always waiting out the travel time.
    - If the travel time passes with the door mid-way, keep reporting
    Opening/Closing for MOVEMENT_GRACE_MS (5s) before reporting Stopped
    (top sensor only).
2026-11-07 Phase 3: modular restructure, topic table, native unit tests, secrets.h
    Structure (no intended behaviour change):
    - main.cpp (was ~2,150 lines) now only wires modules together and owns
    the relays, sensors and WiFi.
    - lib/DoorLogic: hardware-free door state machine (Door), Debouncer and
    CommandGuard - a faithful port of getDoorState() incl. arrival/grace.
    - MqttInterface: connection, birth/LWT, boot report, and every topic in
    one route table that drives subscriptions, retained-command clearing
    and dispatch (replacing two ~20-branch chains).
    - Display: OLED, redraw-on-change, timeout and wake button.
    - Removed the 4KB shared payload buffer and emptyPayload/addToPayload/
    sendMqtt; MQT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
2026-11-07 Don't press the button twice for a repeated command
    Homebridge logs showed MQTT-Thing sending set/target "O" twice within a
    second; G2M pulsed the Open relay twice and restarted the timer. The
    same command within REPEAT_COMMAND_WINDOW_MS (2s) is now treated as a
    repeat: the target is still echoed and a reply sent, but the relay is
    not pulsed again. The window is short so a deliberate re-press still
    works. Four new unit tests (27 total).
2026-11-07 Phase 4: Home Assistant discovery, device health, hang watchdog, v2.1
    - Home Assistant MQTT discovery (HomeAssistant module): a garage door
    cover, reboot button and diagnostic sensors (WiFi signal, free memory,
    last boot, last reset reason) appear automatically; reuses existing
    topics. HOME_ASSISTANT_DISCOVERY turns it off. MQTT buffer 512 ->
    1024 bytes for the configs.
    - <device>/device/status, retained, on connect and every heartbeat:
    uptime, RSSI, free and minimum free heap.
    - Task watchdog (WATCHDOG_TIMEOUT_S, 30s) reboots the device if the
    loop hangs; fed every loop, during boot waits and through OTA uploads.
    - set/target "S" (Home Assistant's stop) now stops without echoing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
2026-11-07 HA: report door position so a stop isn't shown as closed; Door status sensor; wake pin diagnostics
